JuanHauara/FPGA_development_board/doc/fotos/IMG_20260930_131612.jpg

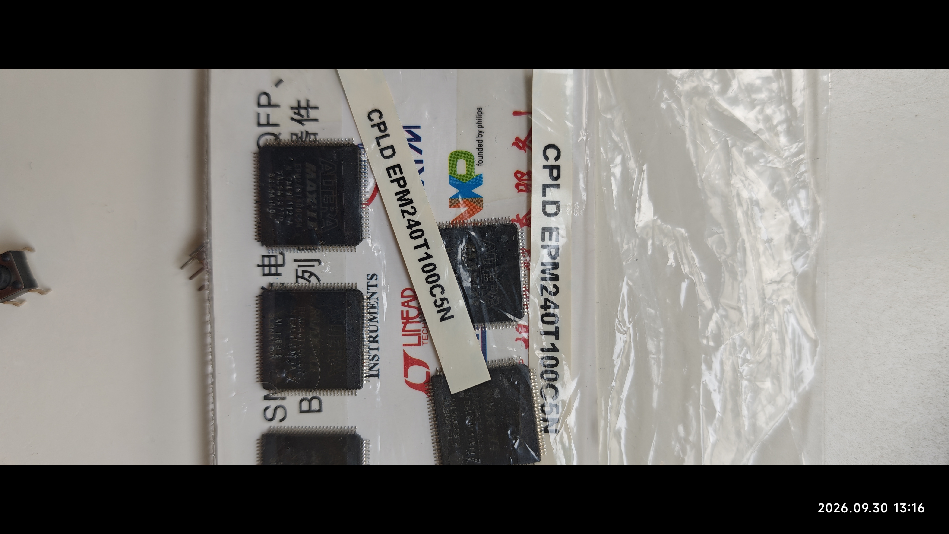
doc/fotos/IMG_20260930_131612.jpg
