JuanHauara/FPGA_development_board/doc/Datasheet/Conector hembra DC-005 alimentación CC.png

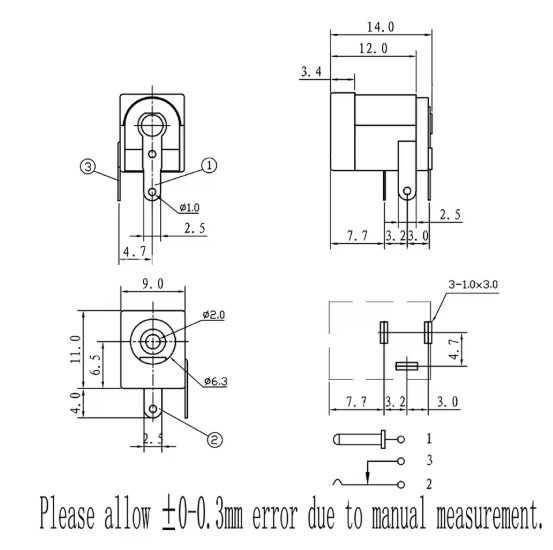
doc/Datasheet/Conector hembra DC-005 alimentación CC.png
