JuanHauara/FPGA_development_board/doc/Datasheet/seven-segment-display-diagram.jpg

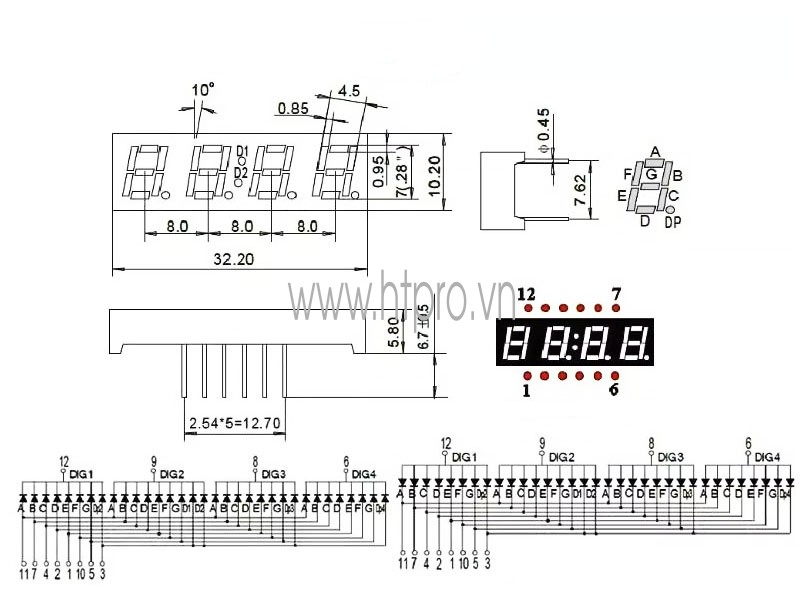
doc/Datasheet/seven-segment-display-diagram.jpg
