JuanHauara/FPGA_development_board/doc/fotos/IMG_20260930_124302.jpg

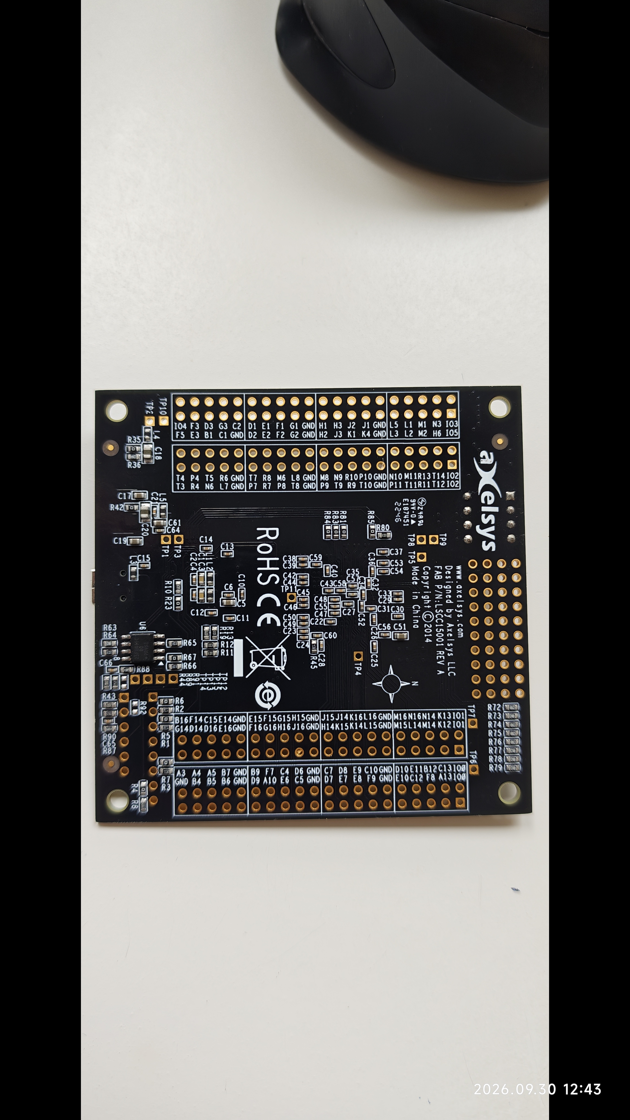
doc/fotos/IMG_20260930_124302.jpg
