JuanHauara/FPGA_development_board/doc/fotos/IMG_20260930_124416.jpg

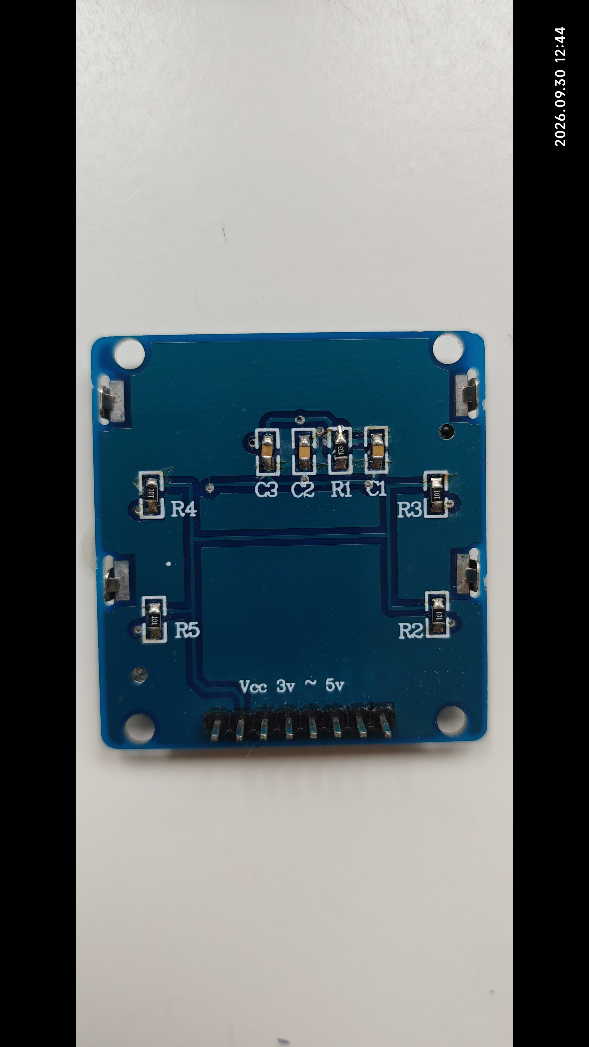
doc/fotos/IMG_20260930_124416.jpg
