JuanHauara/FPGA_development_board/doc/fotos/IMG_20260930_124644.jpg

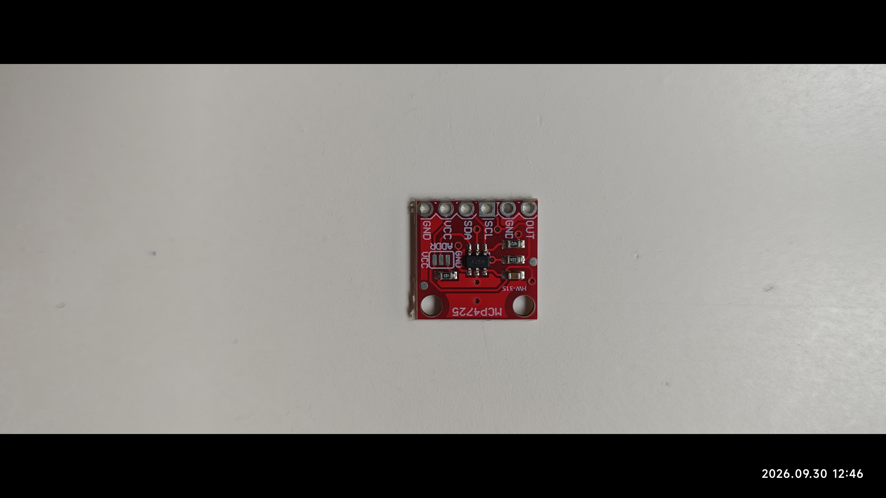
doc/fotos/IMG_20260930_124644.jpg
