JuanHauara/FPGA_development_board/doc/fotos/IMG_20260930_125004.jpg

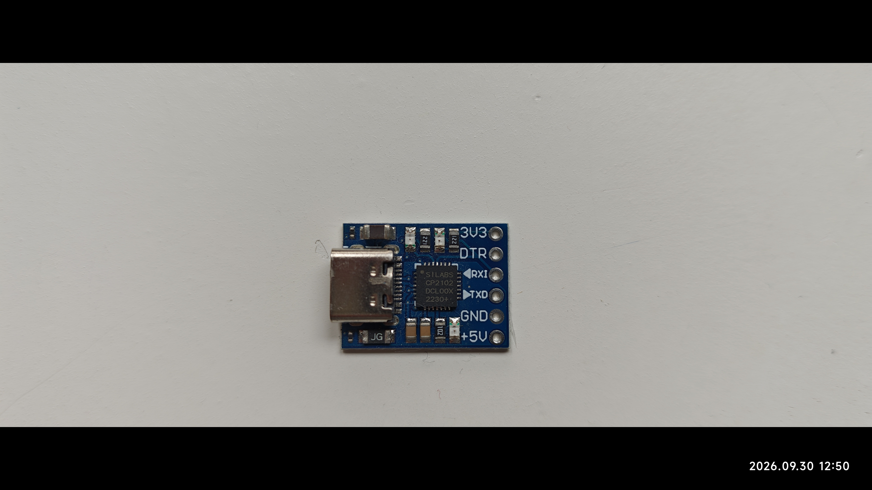
doc/fotos/IMG_20260930_125004.jpg
