JuanHauara/FPGA_development_board/doc/fotos/IMG_20260930_130410.jpg

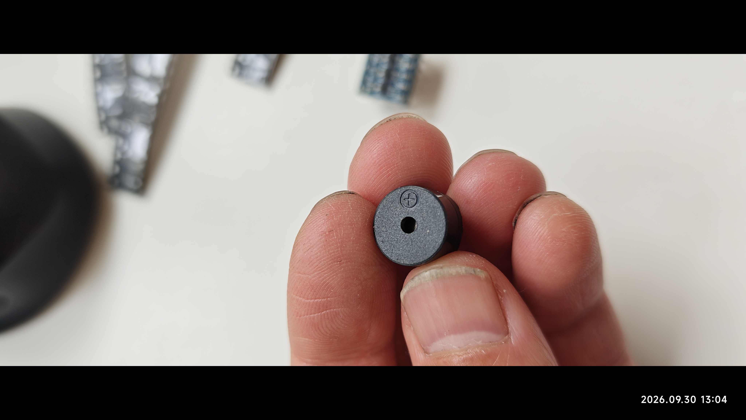
doc/fotos/IMG_20260930_130410.jpg
