JuanHauara/FPGA_development_board/doc/fotos/IMG_20260930_130453.jpg

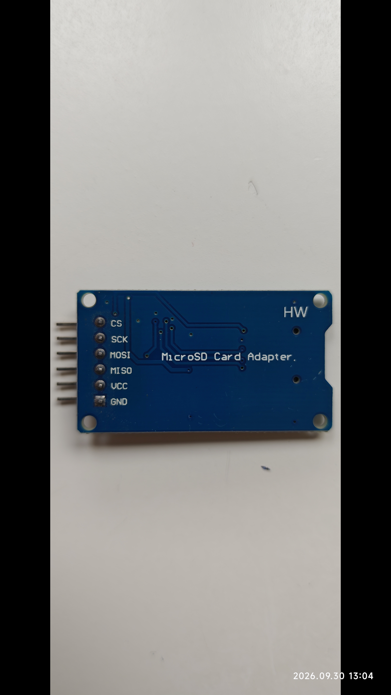
doc/fotos/IMG_20260930_130453.jpg
