JuanHauara/FPGA_development_board/doc/fotos/IMG_20260930_130505.jpg

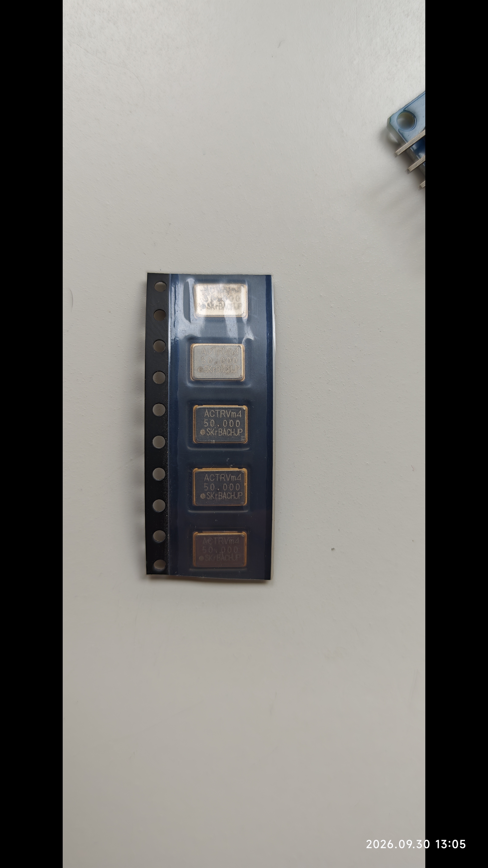
doc/fotos/IMG_20260930_130505.jpg
