JuanHauara/FPGA_development_board/doc/fotos/IMG_20260930_131454.jpg

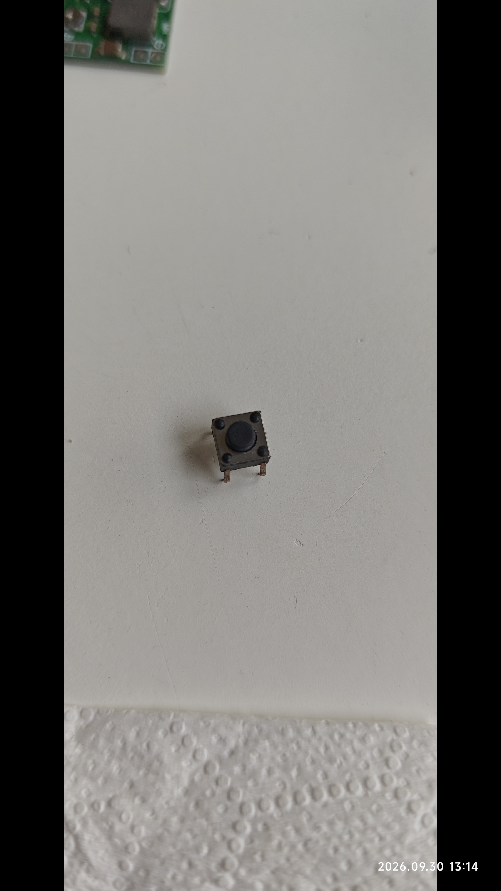
doc/fotos/IMG_20260930_131454.jpg
