JuanHauara/FPGA_development_board/doc/fotos/IMG_20260930_132716.jpg

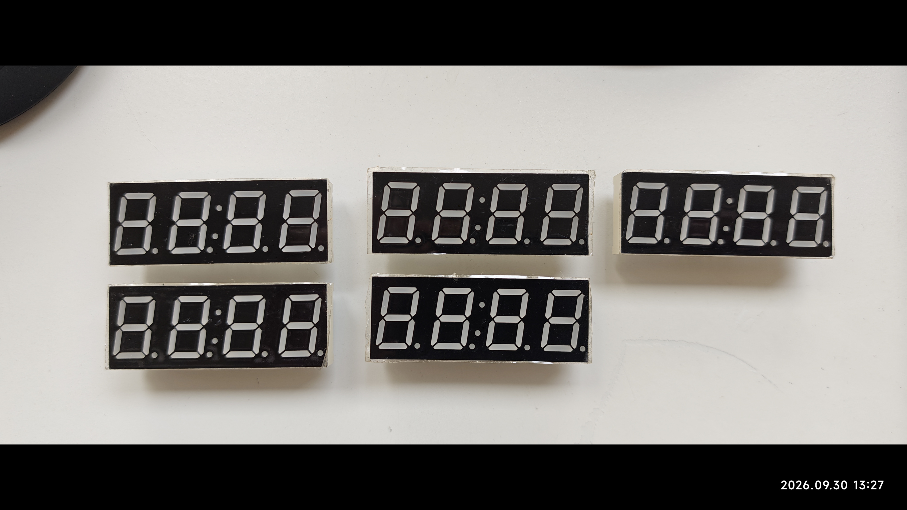
doc/fotos/IMG_20260930_132716.jpg
