JuanHauara/FPGA_development_board/doc/fotos/IMG_20260930_132906.jpg

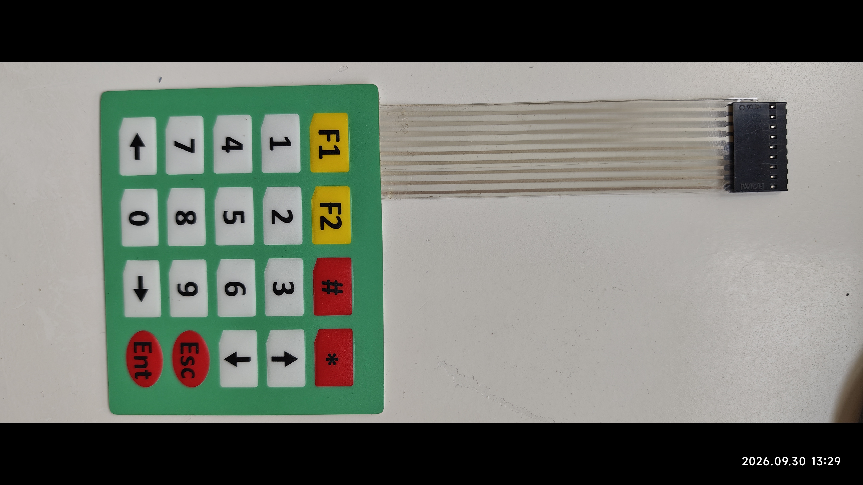
doc/fotos/IMG_20260930_132906.jpg
