JuanHauara/FPGA_development_board/doc/imgs/TSOP II 32 - SRAM.jpg

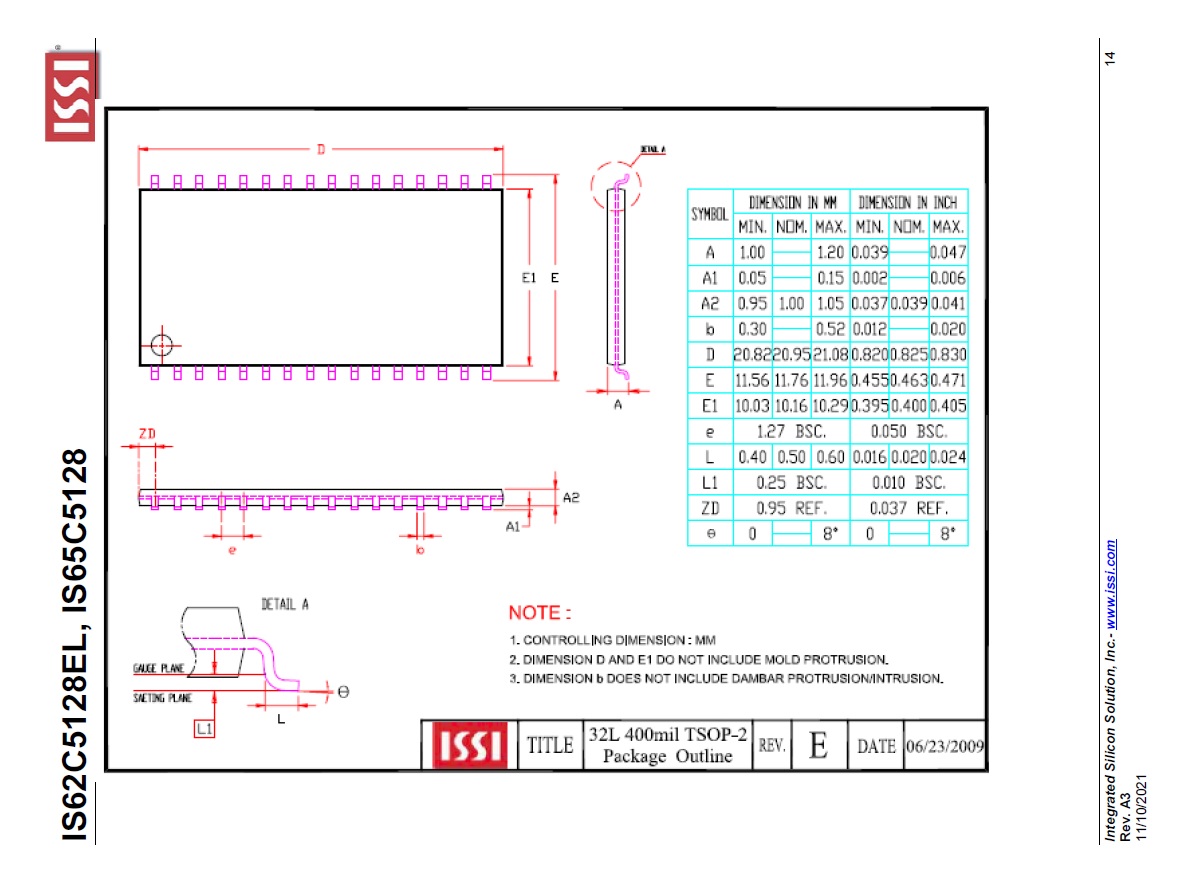
doc/imgs/TSOP II 32 - SRAM.jpg
