JuanHauara/FPGA_development_board/tmp/pdfs/nxp244local.png

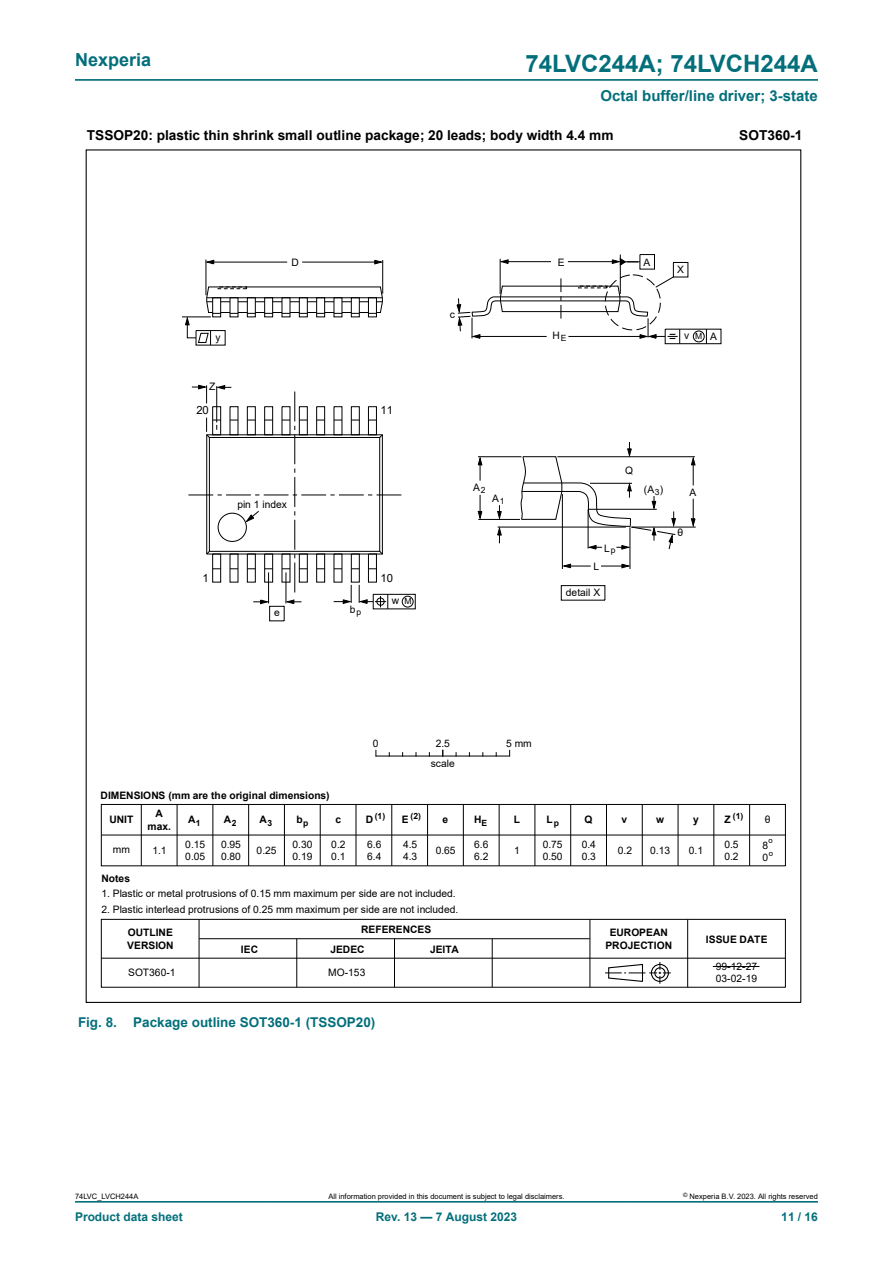
tmp/pdfs/nxp244local.png
