JuanHauara/FPGA_development_board/tmp/pdfs/ti244.png

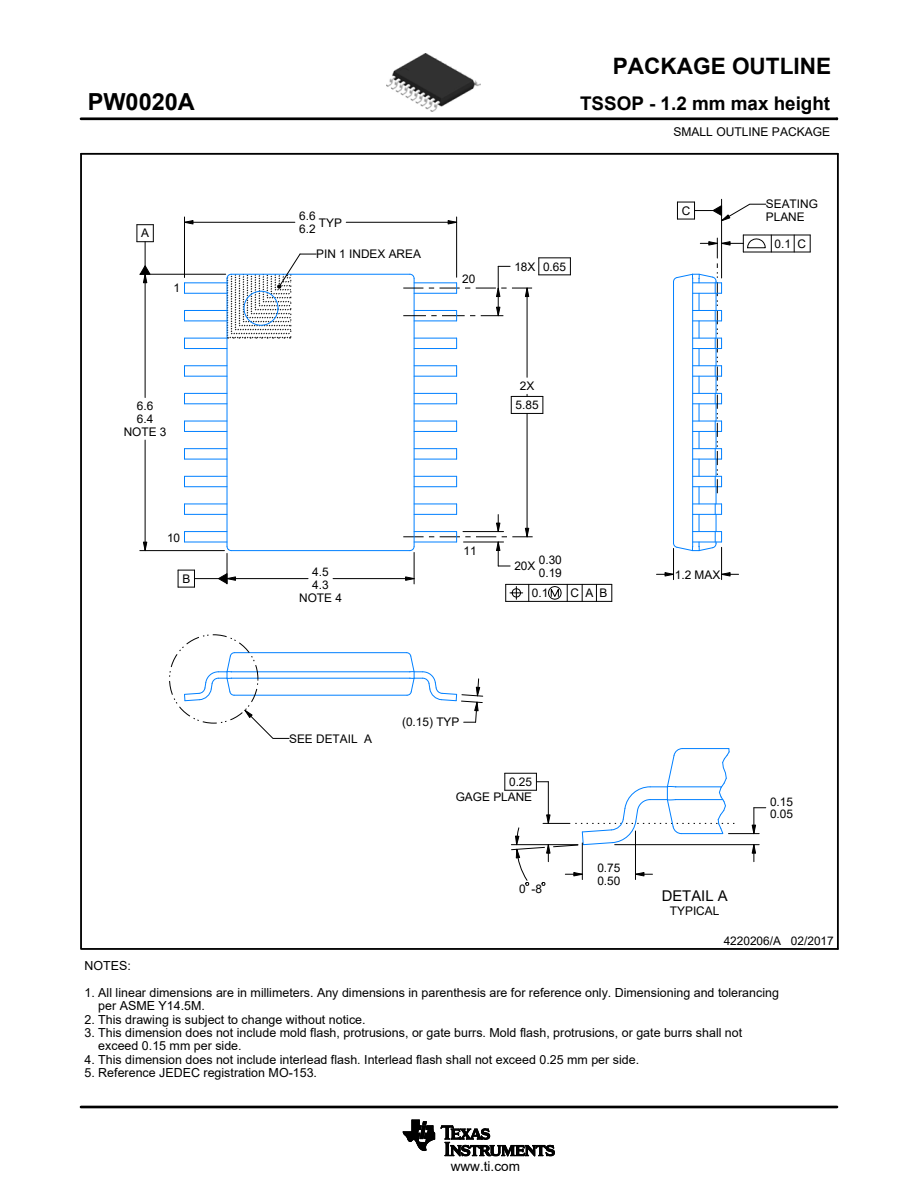
tmp/pdfs/ti244.png
