JuanHauara/FPGA_development_board/doc/Datasheet/Placa_MCUDev_DevEBox_STM32H7XX_M/PCB_measures.png

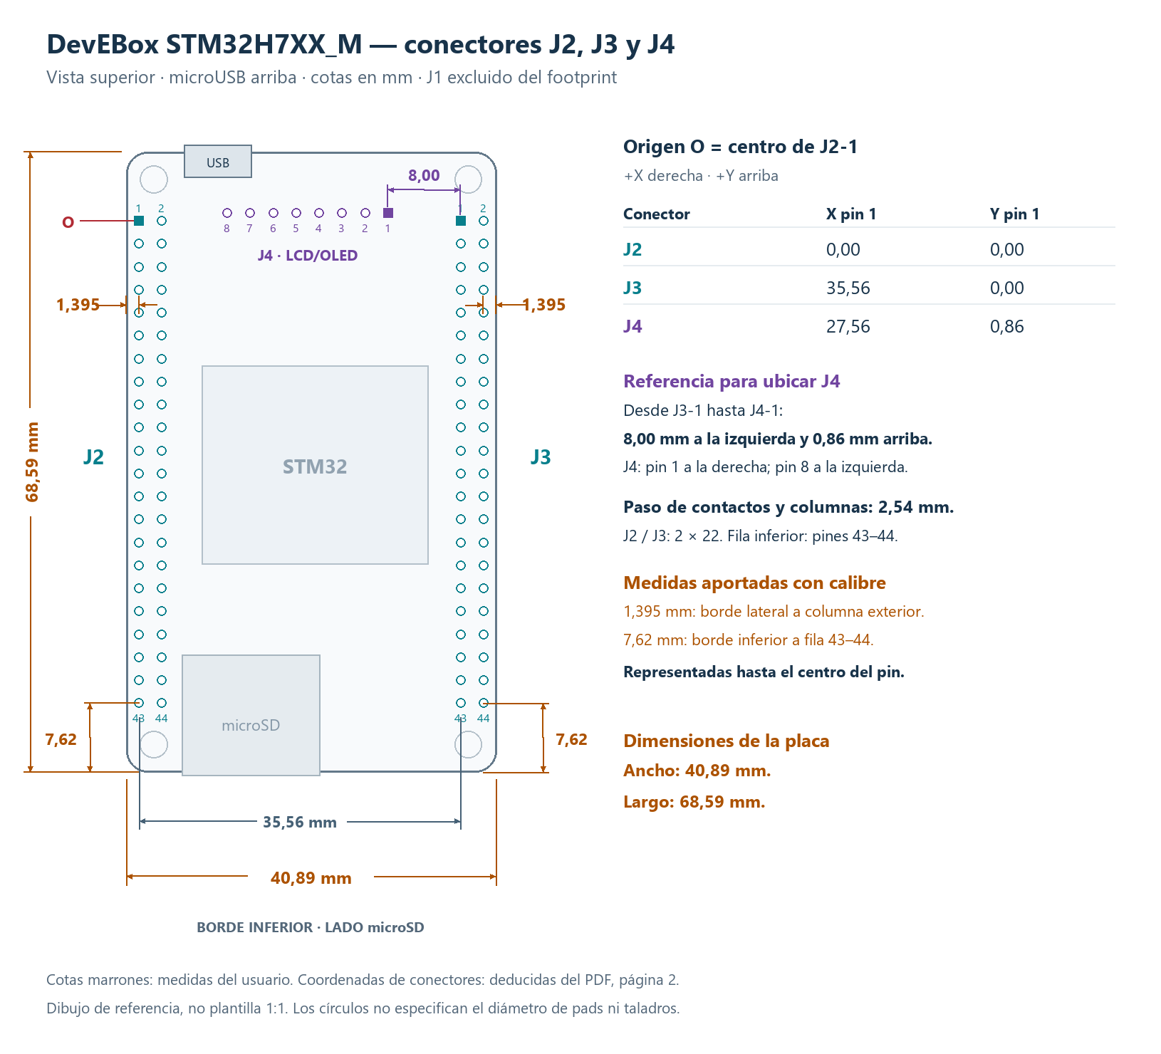
doc/Datasheet/Placa_MCUDev_DevEBox_STM32H7XX_M/PCB_measures.png
