JuanHauara/FPGA_development_board/doc/Export/Lattice_FPGA_development_board.pdf

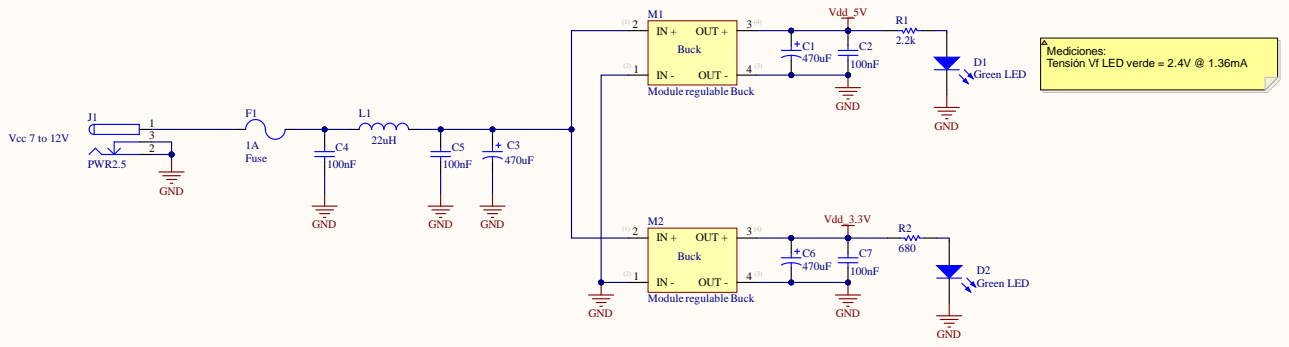
[picture p28: page 1]

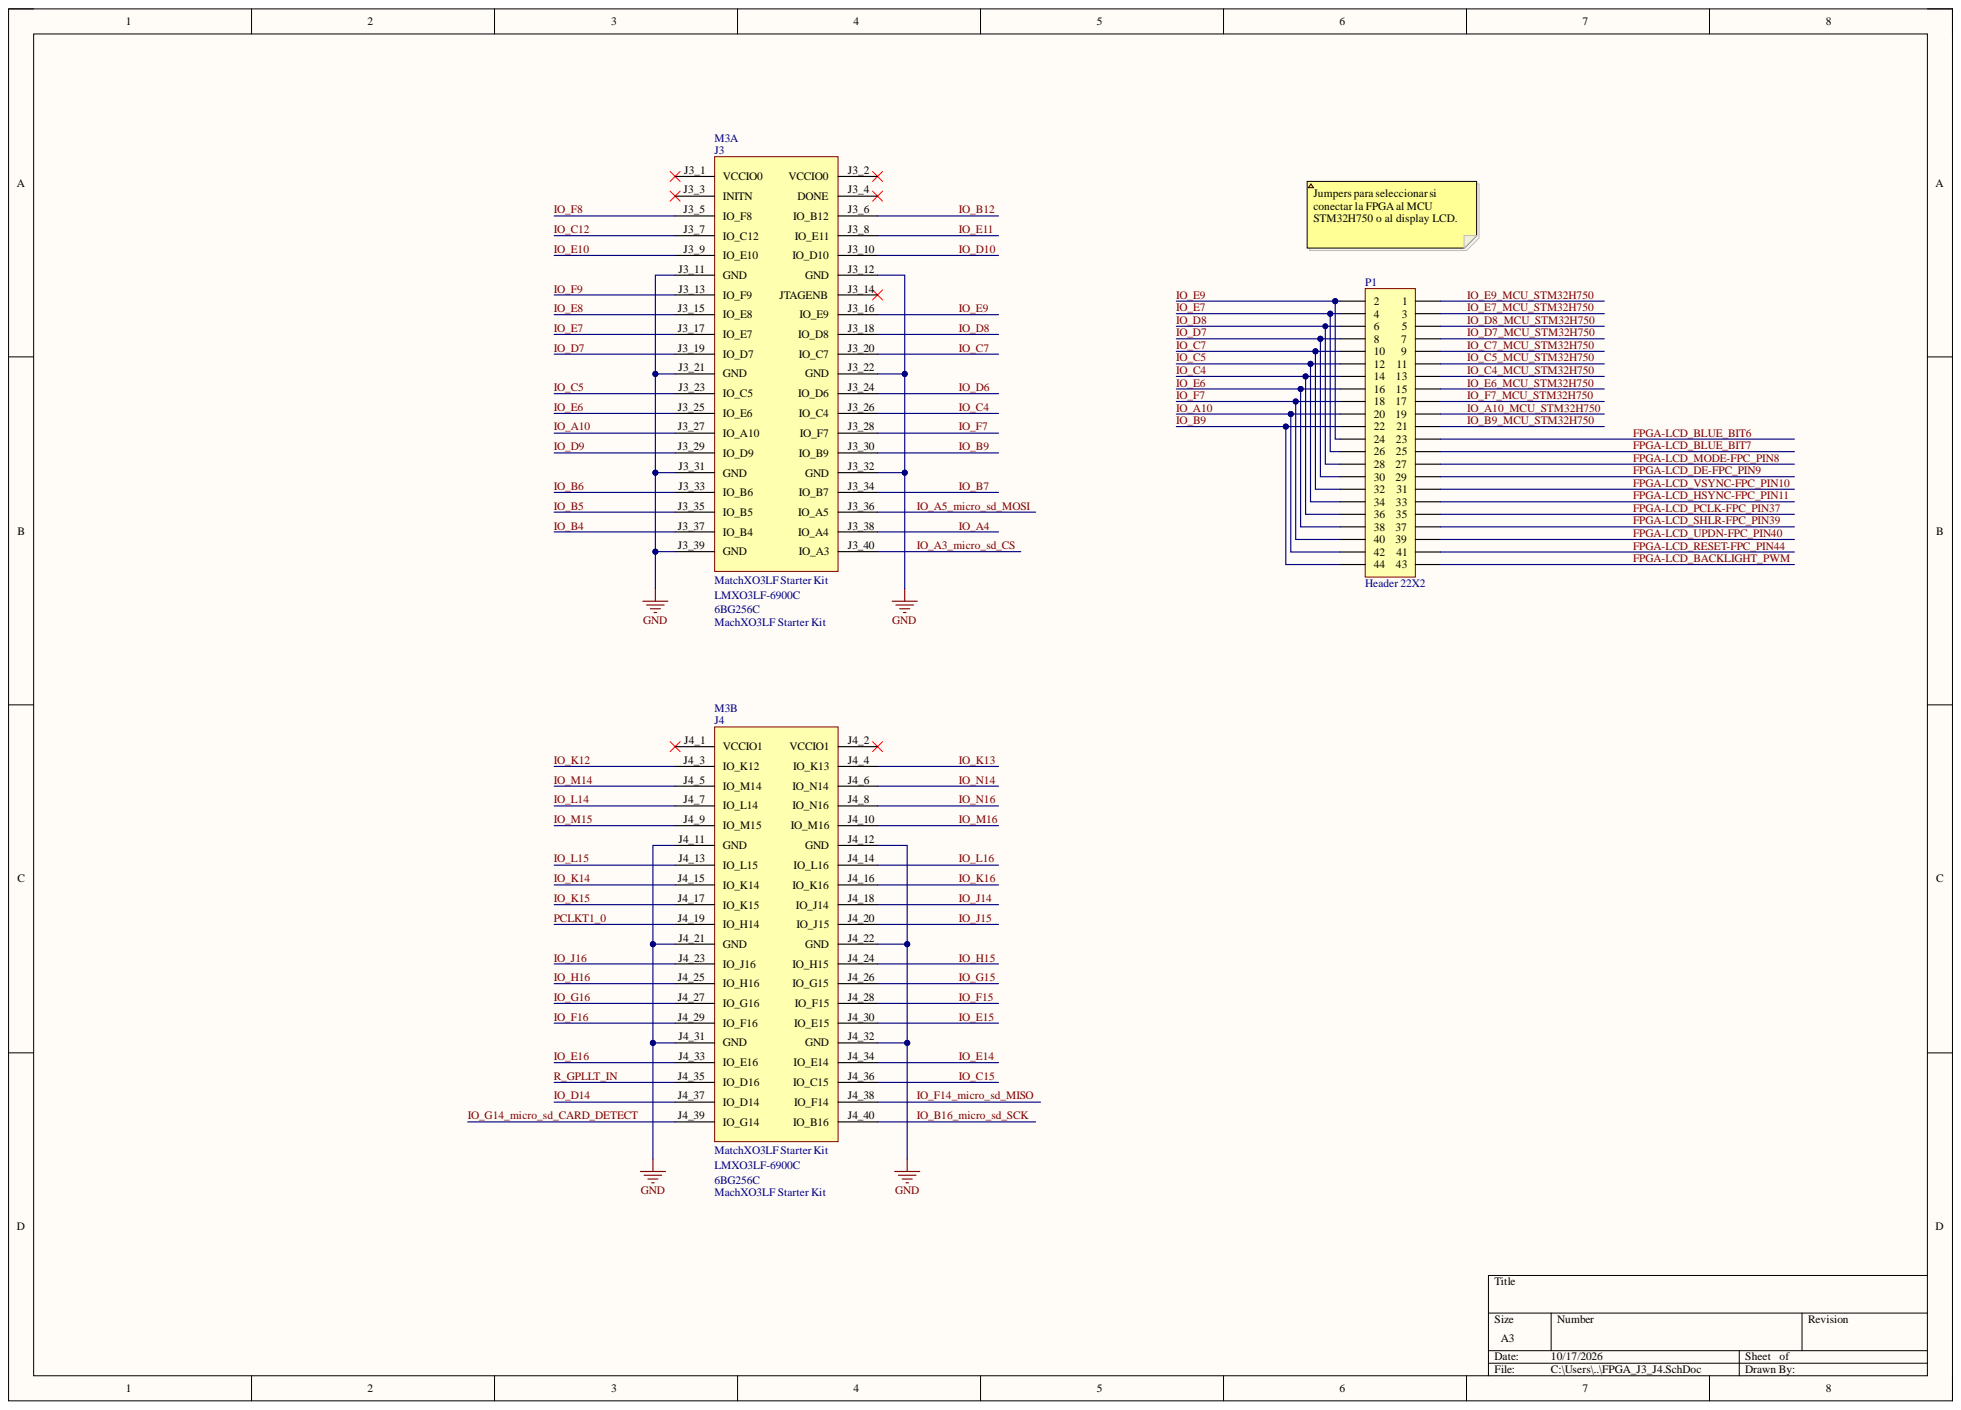
[picture p29: page 2]

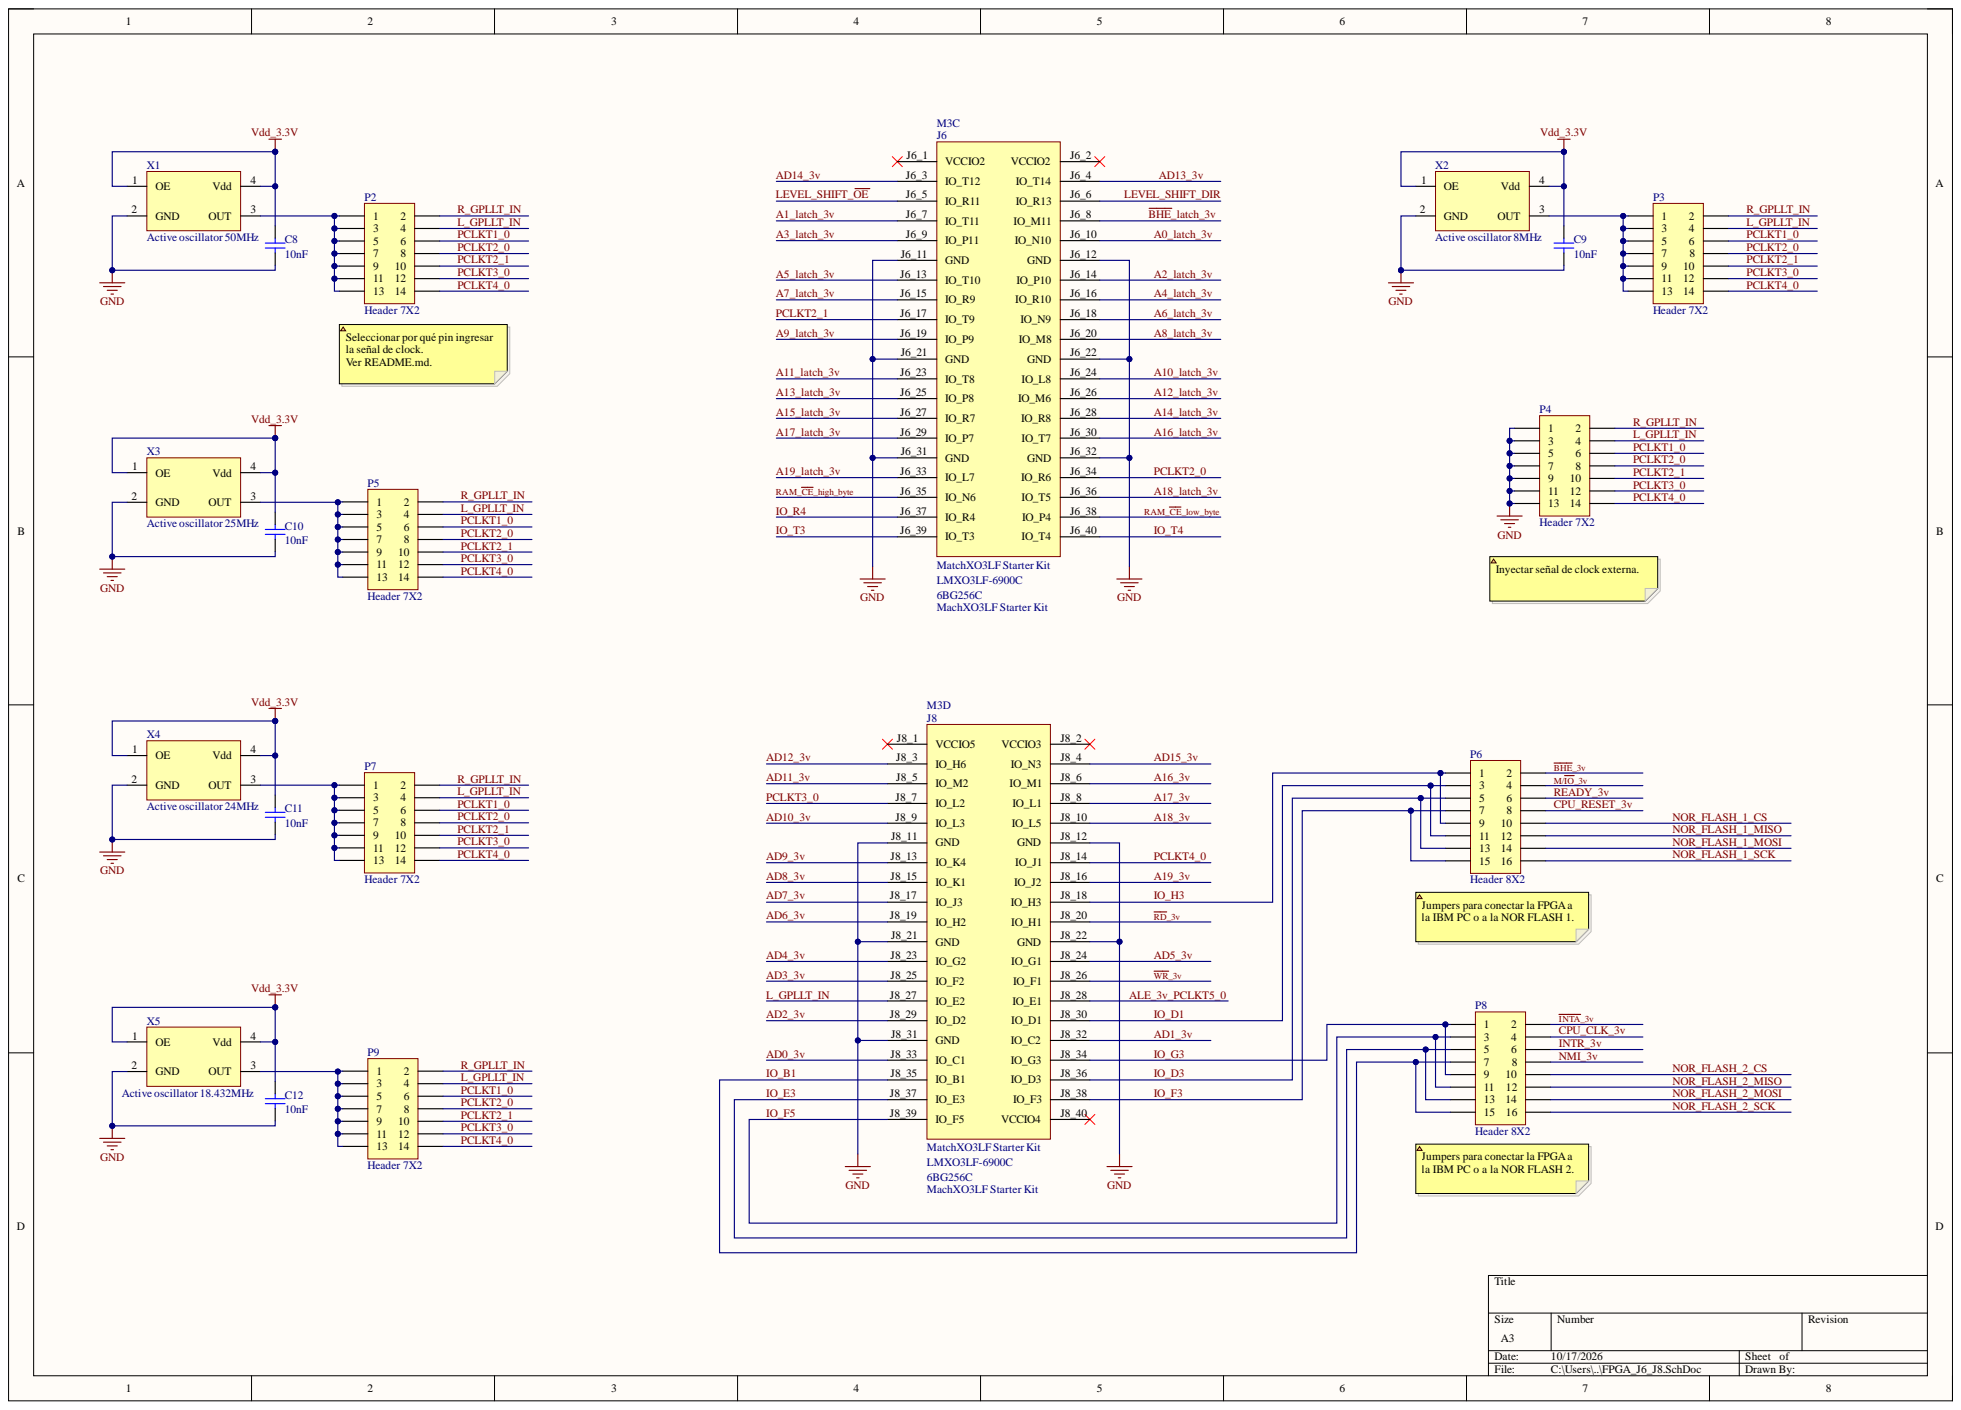
[picture p30: page 3]

ñal de clock externa.

J8_3 0 | I O_D 1
J8_3 2 J8_3 4 | | A D1_3v I O_G 3

Act Hz

I O_E 3 | J8_3 7 | J8_3 8 | I O_F3
I O_F5 | J8_3 9 | J8_4 0

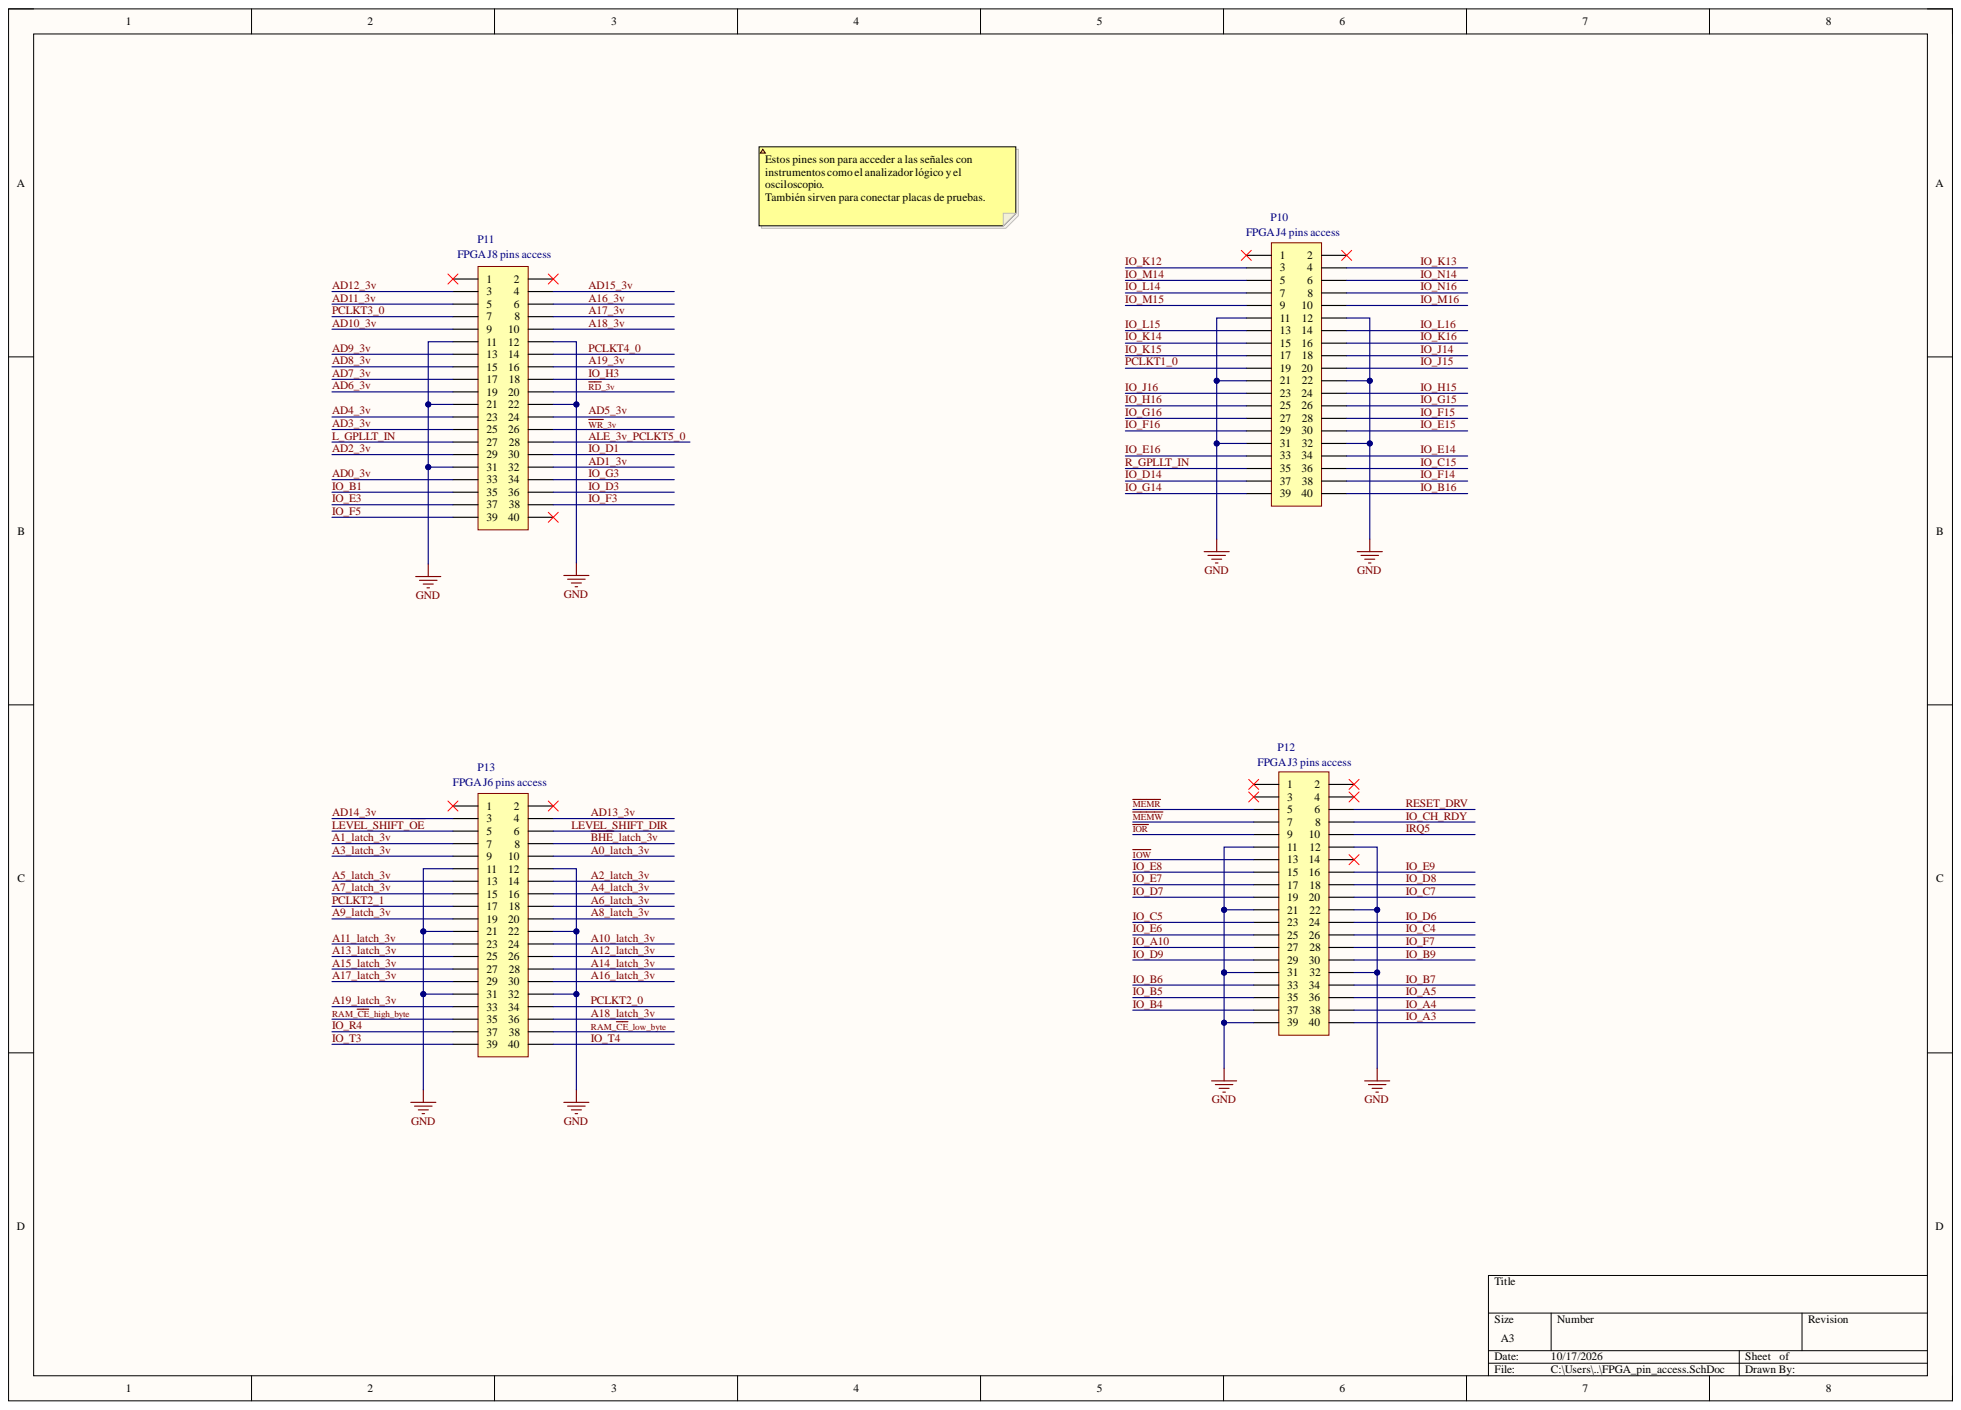
[picture p31: page 4]

rven para conectar placas de pruebas

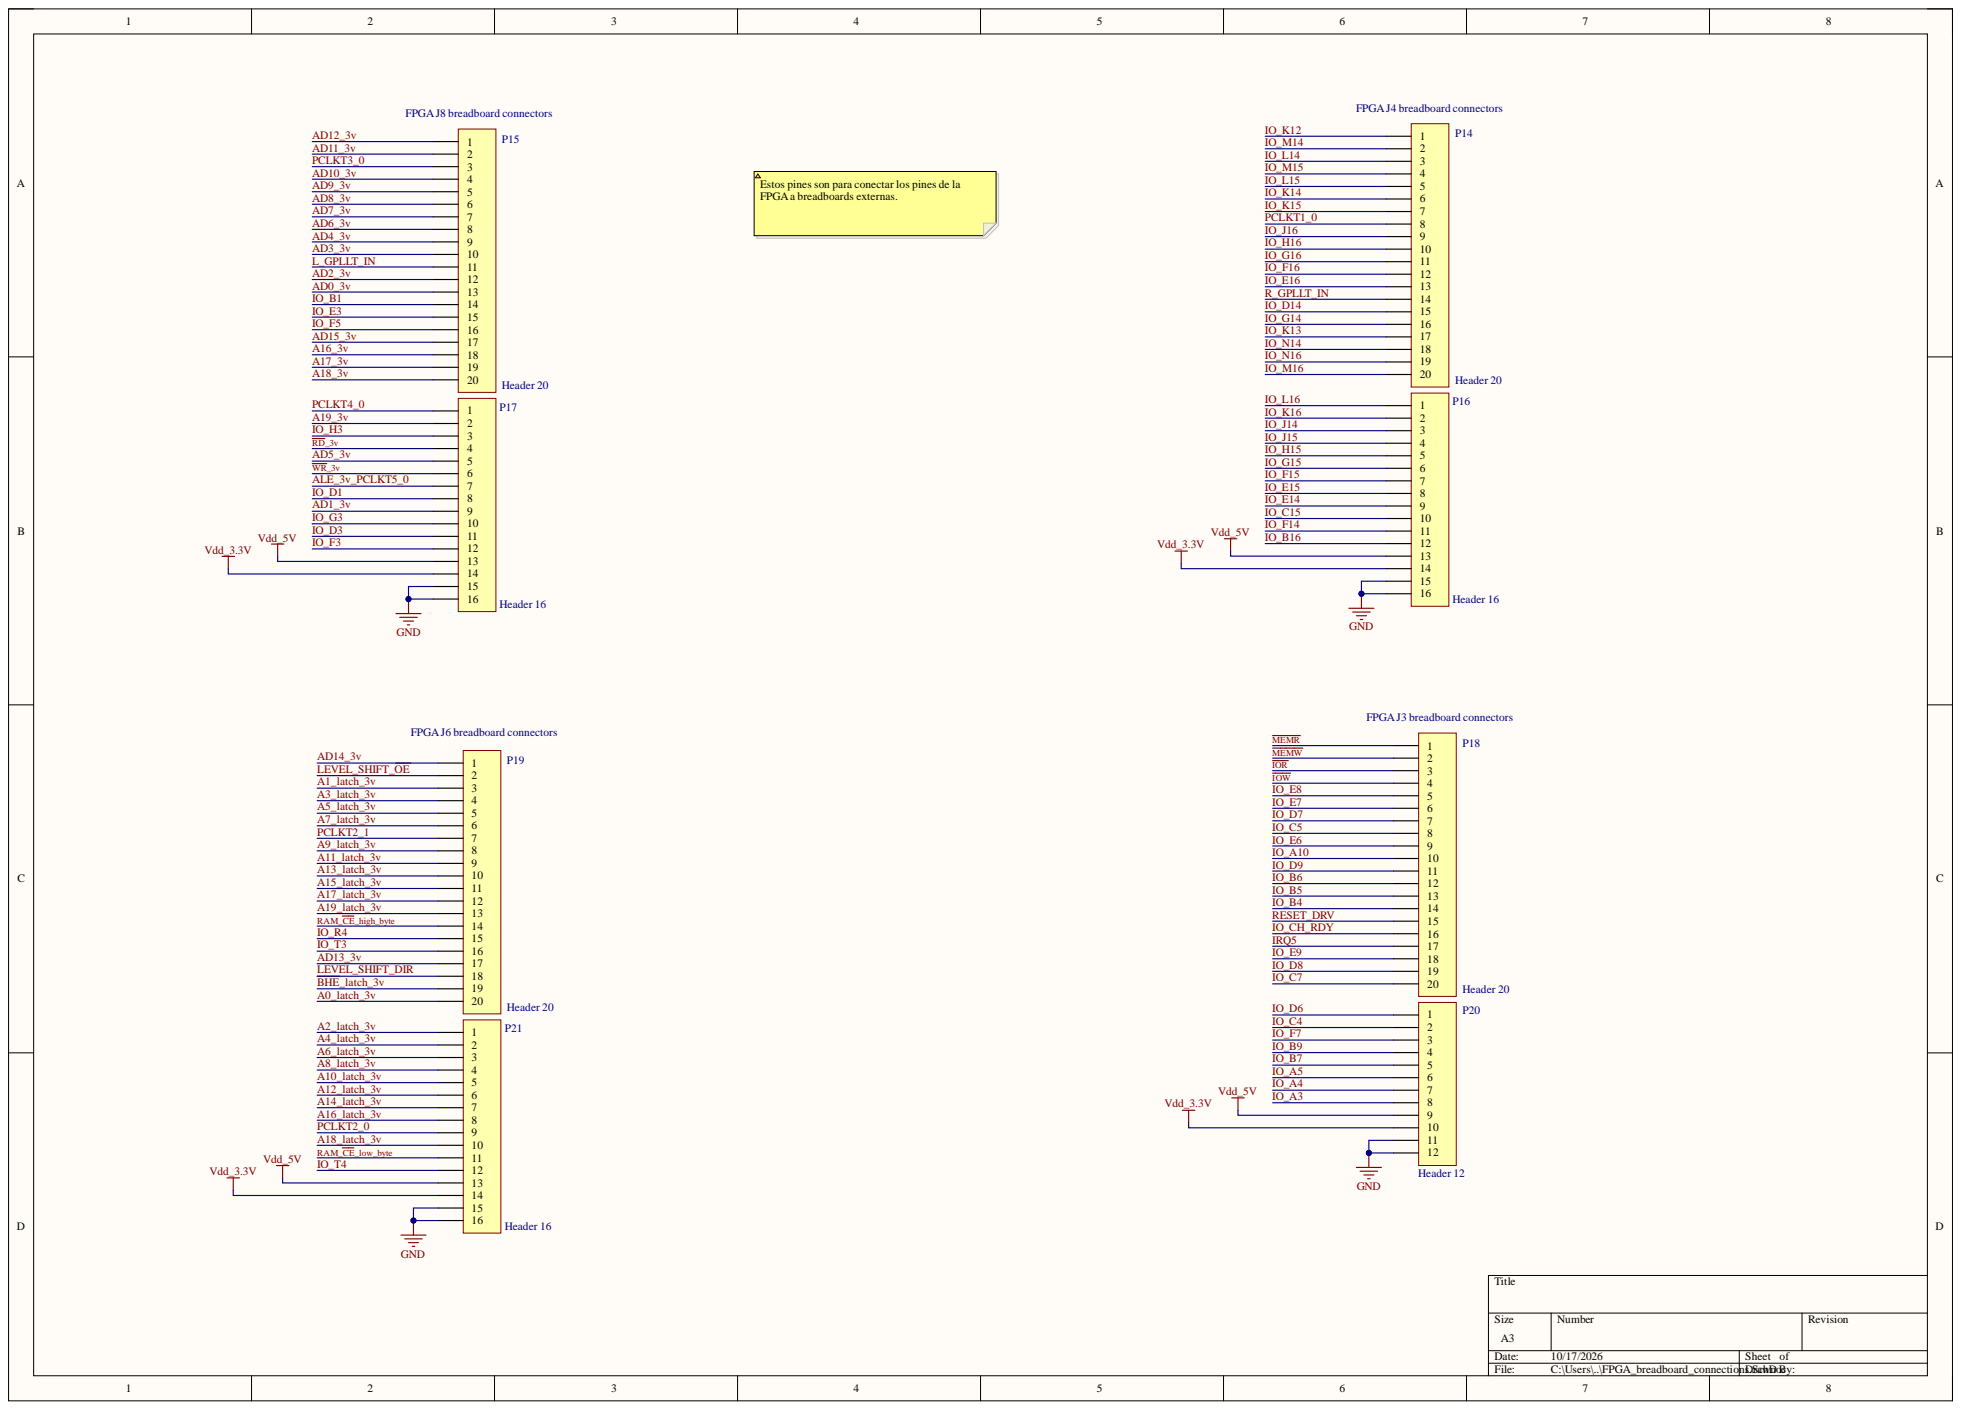
[picture p32: page 5]

ionsD.Sch rawDn Bocy:

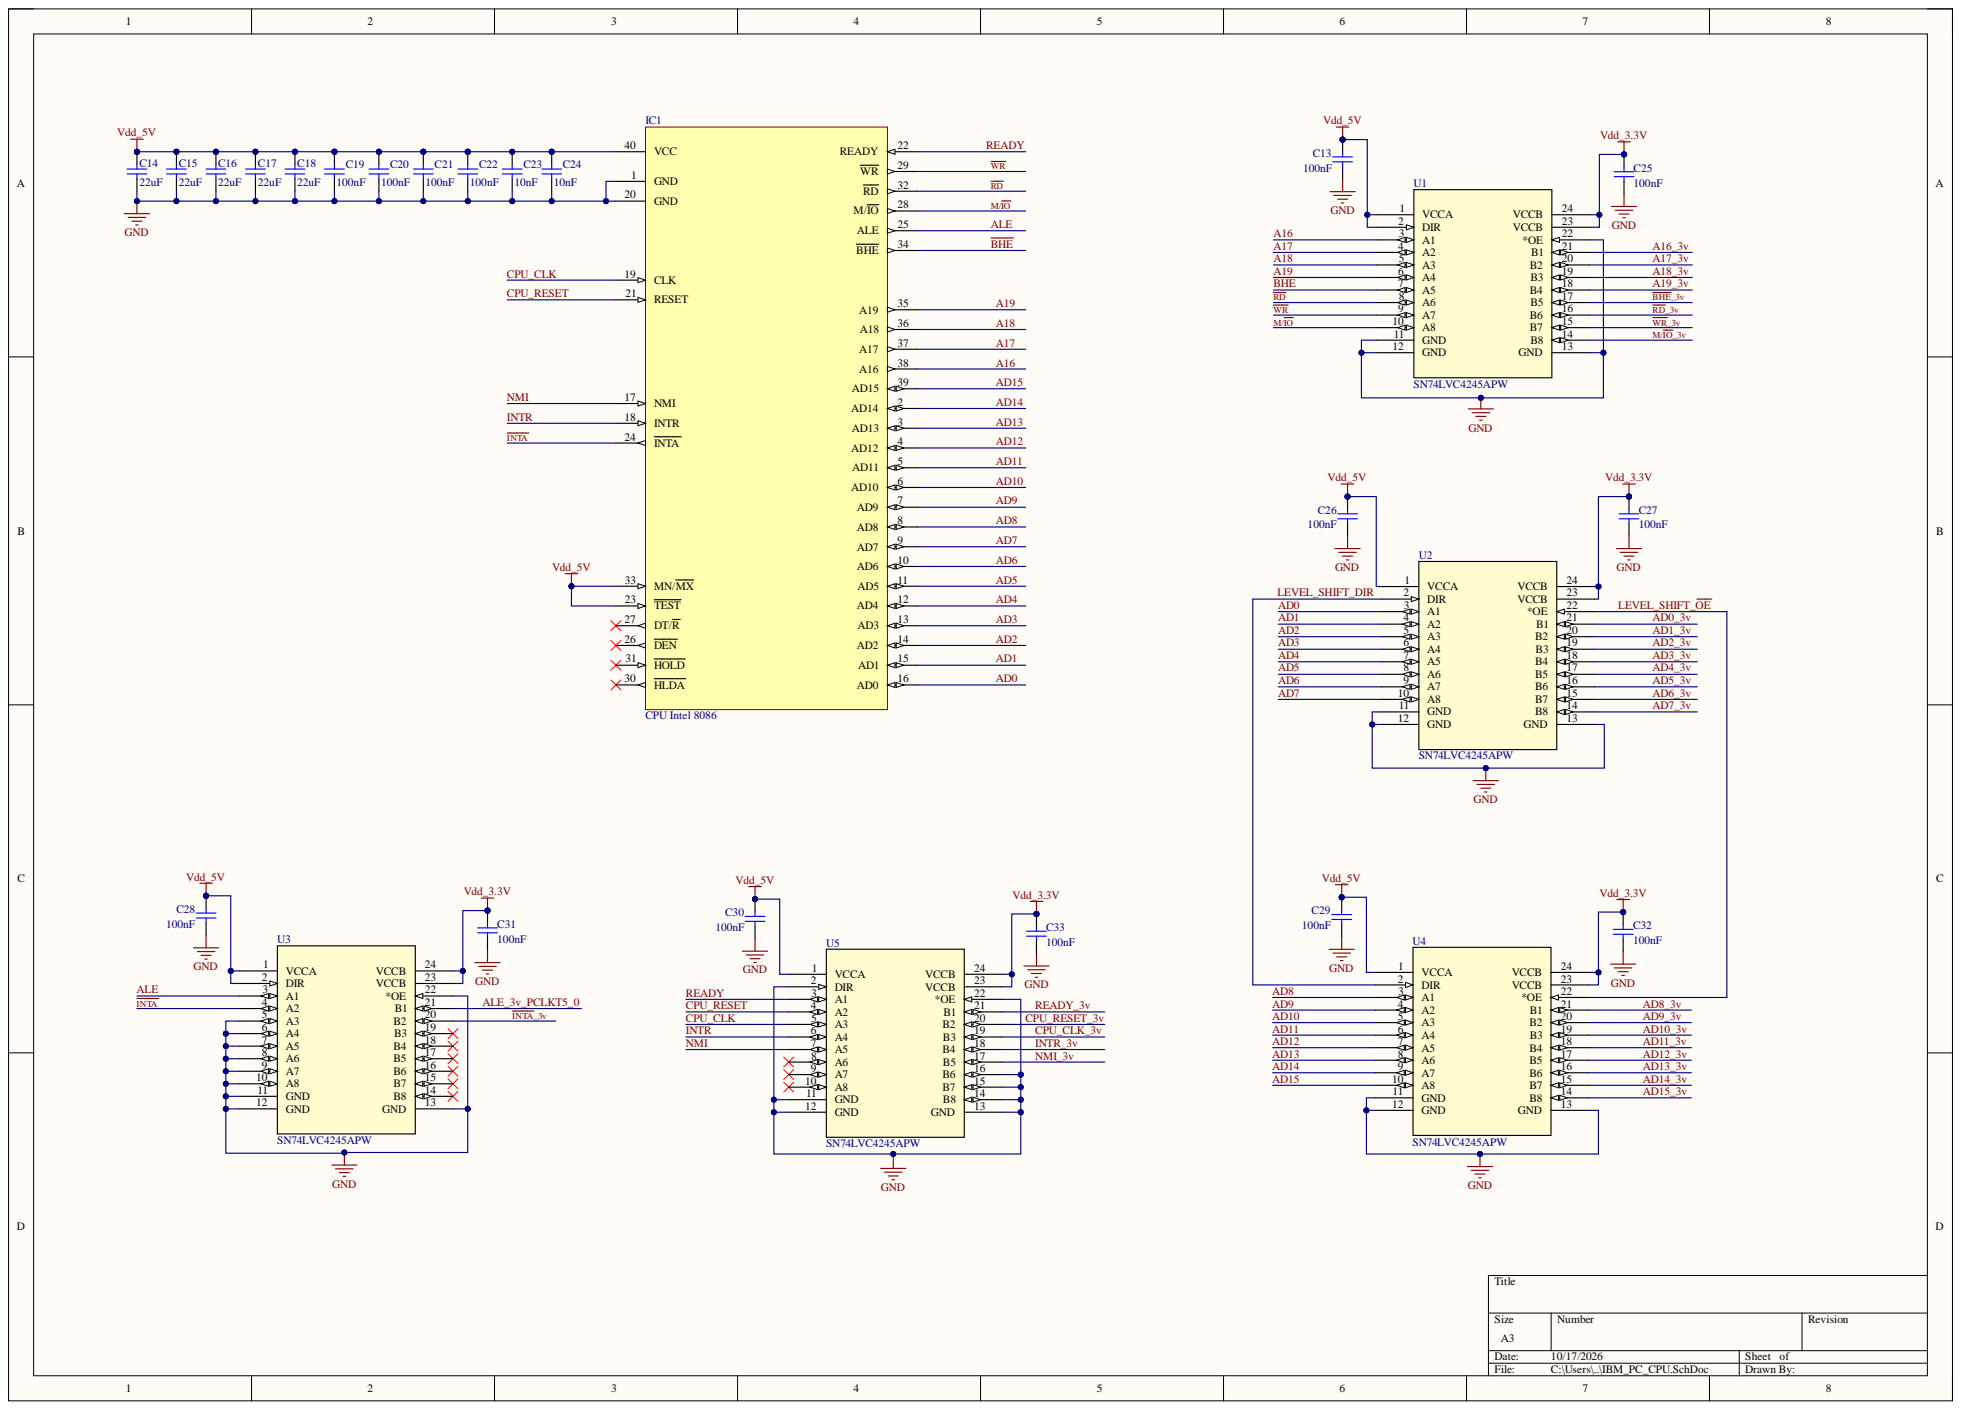
[picture p33: page 6]

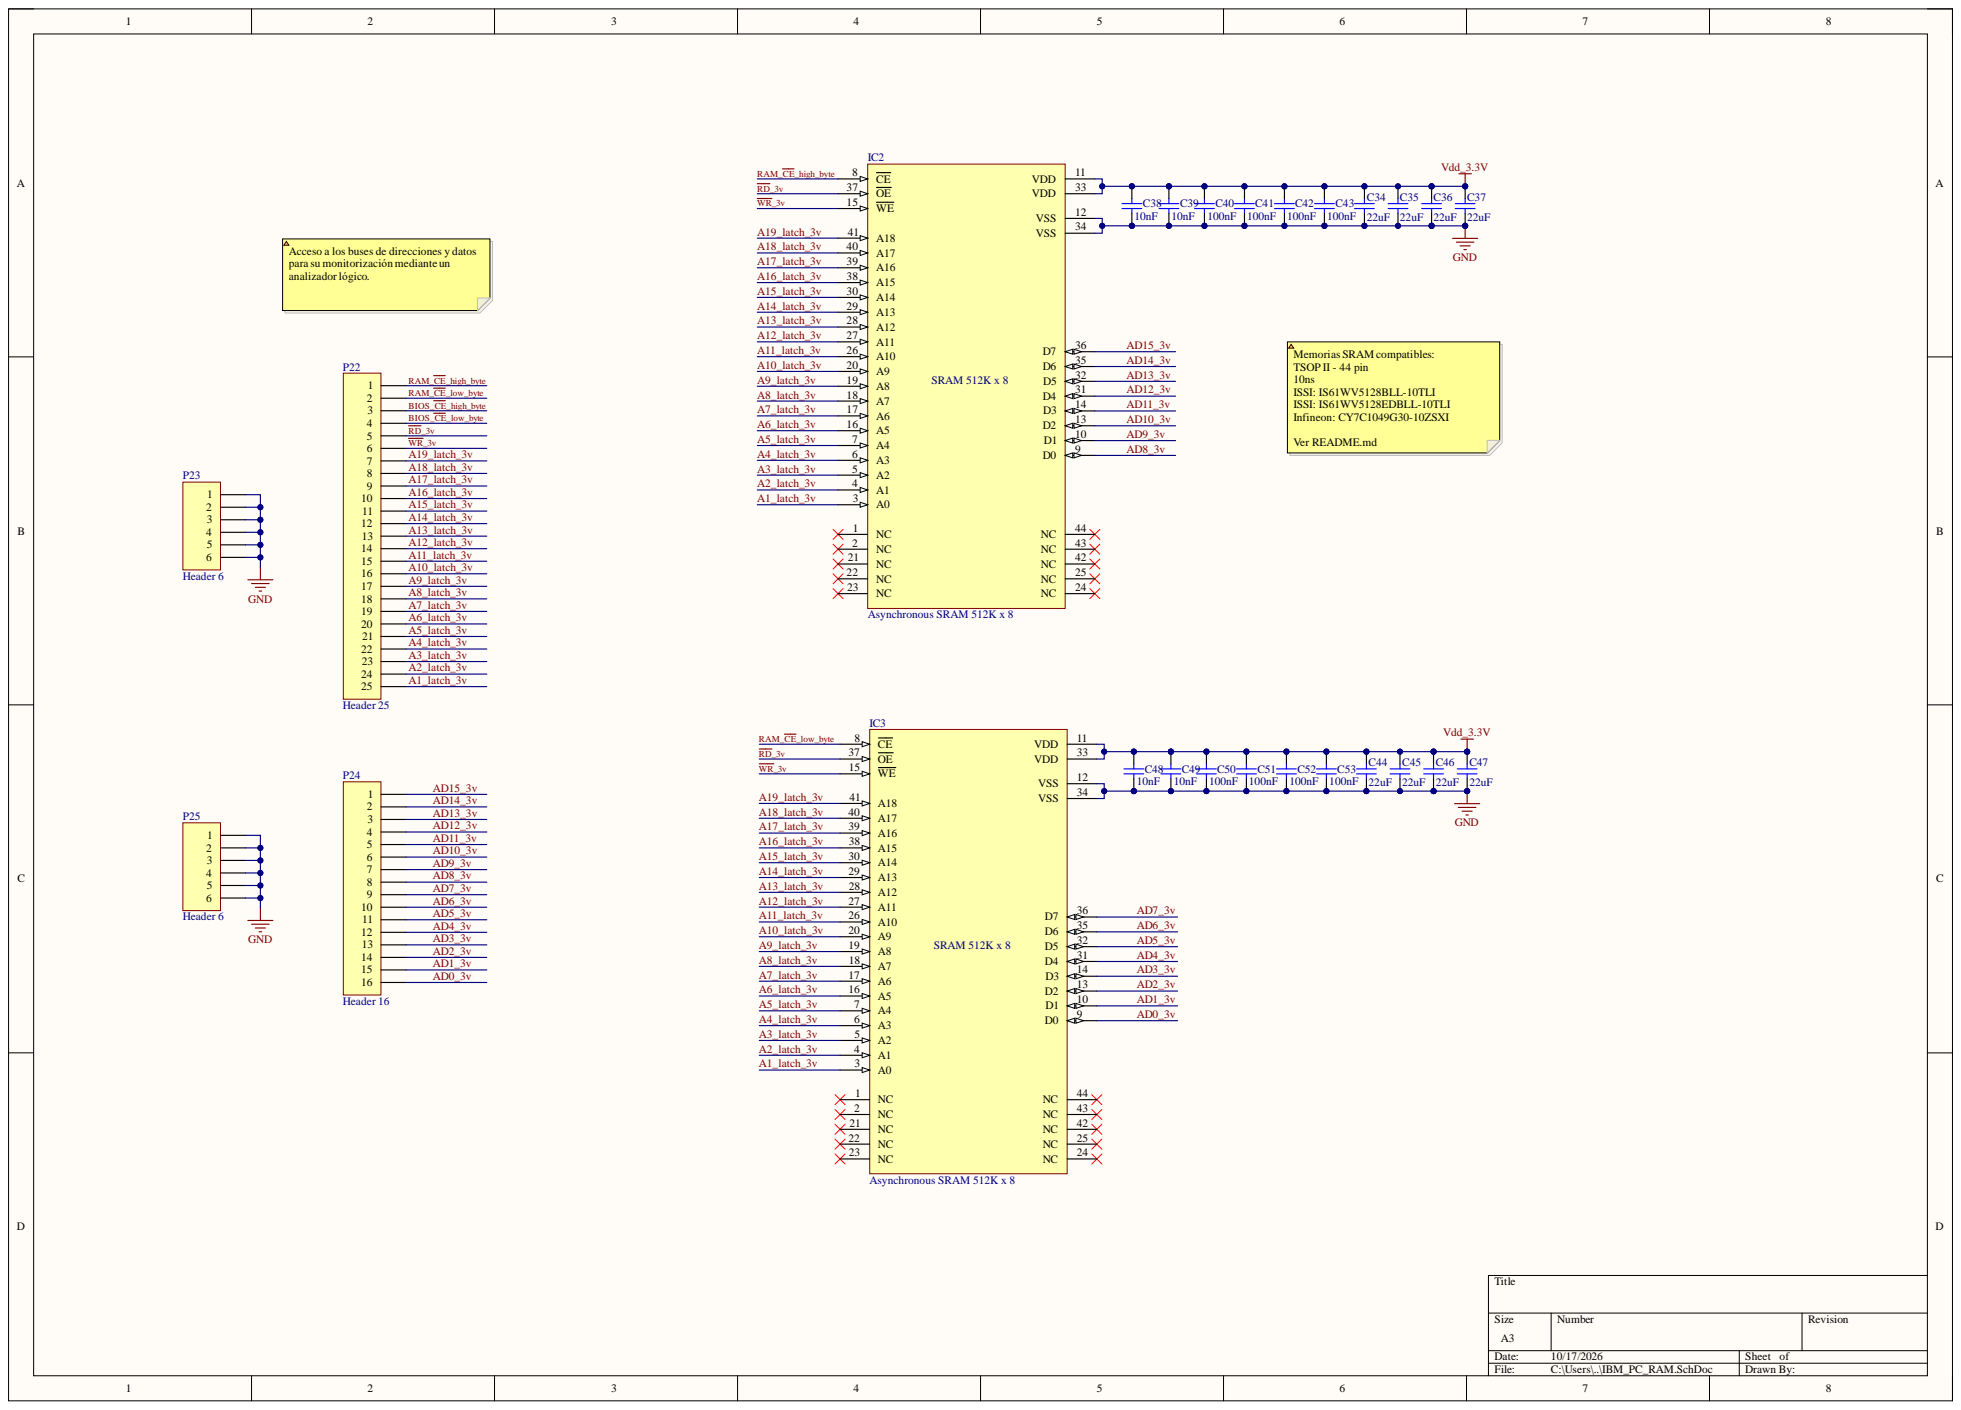
[picture p34: page 7]

los buses de di
izador

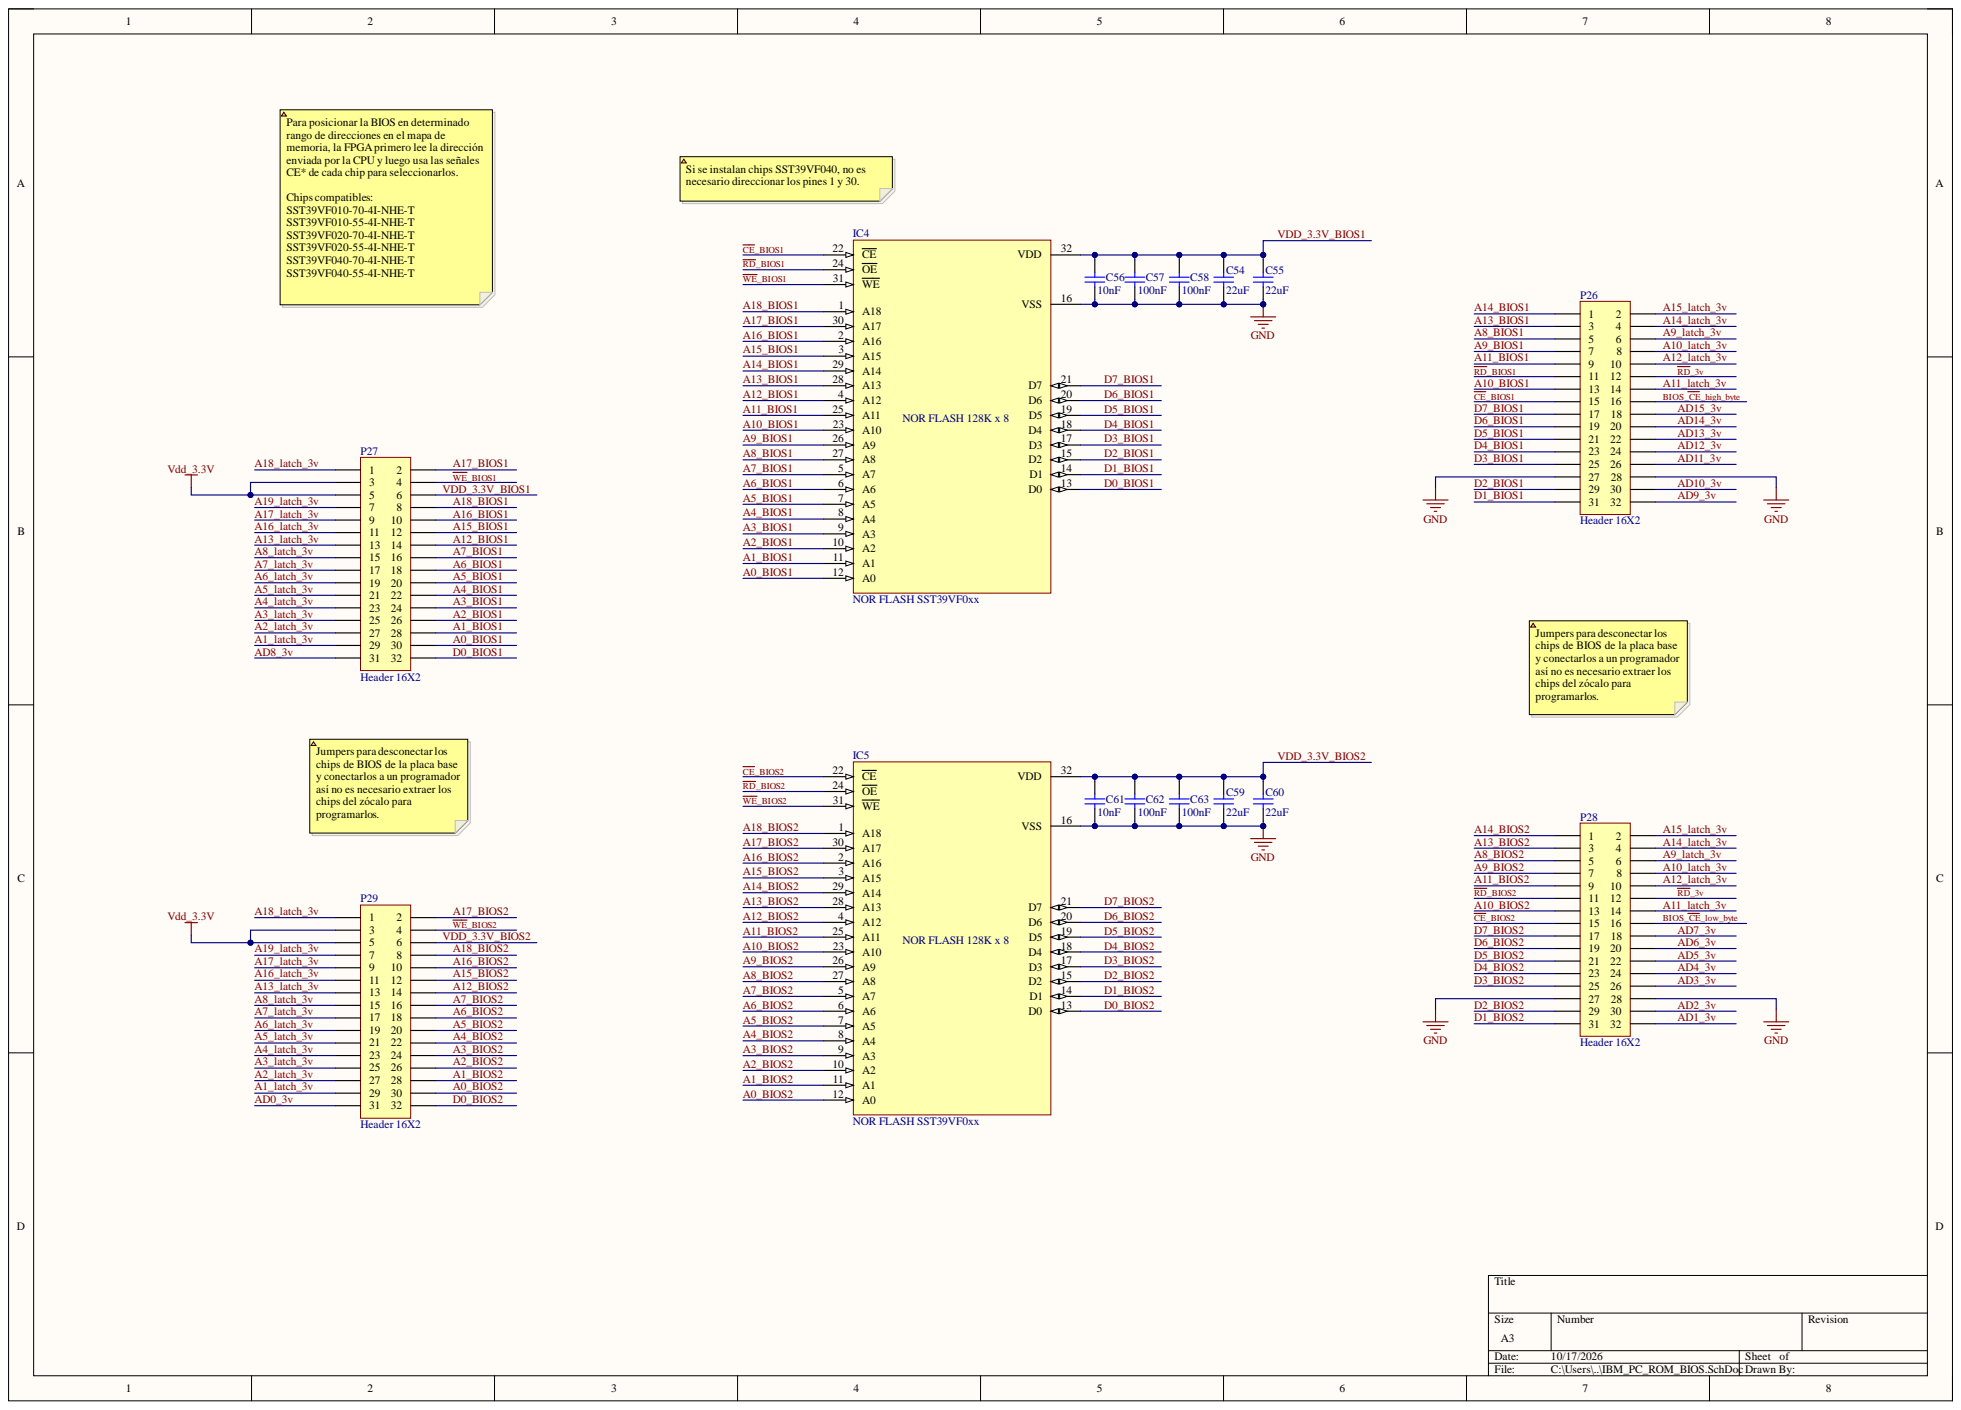
[picture p35: page 8]

E* de cada chip para

talan chips SST39VF040, no es

OS de la placa base

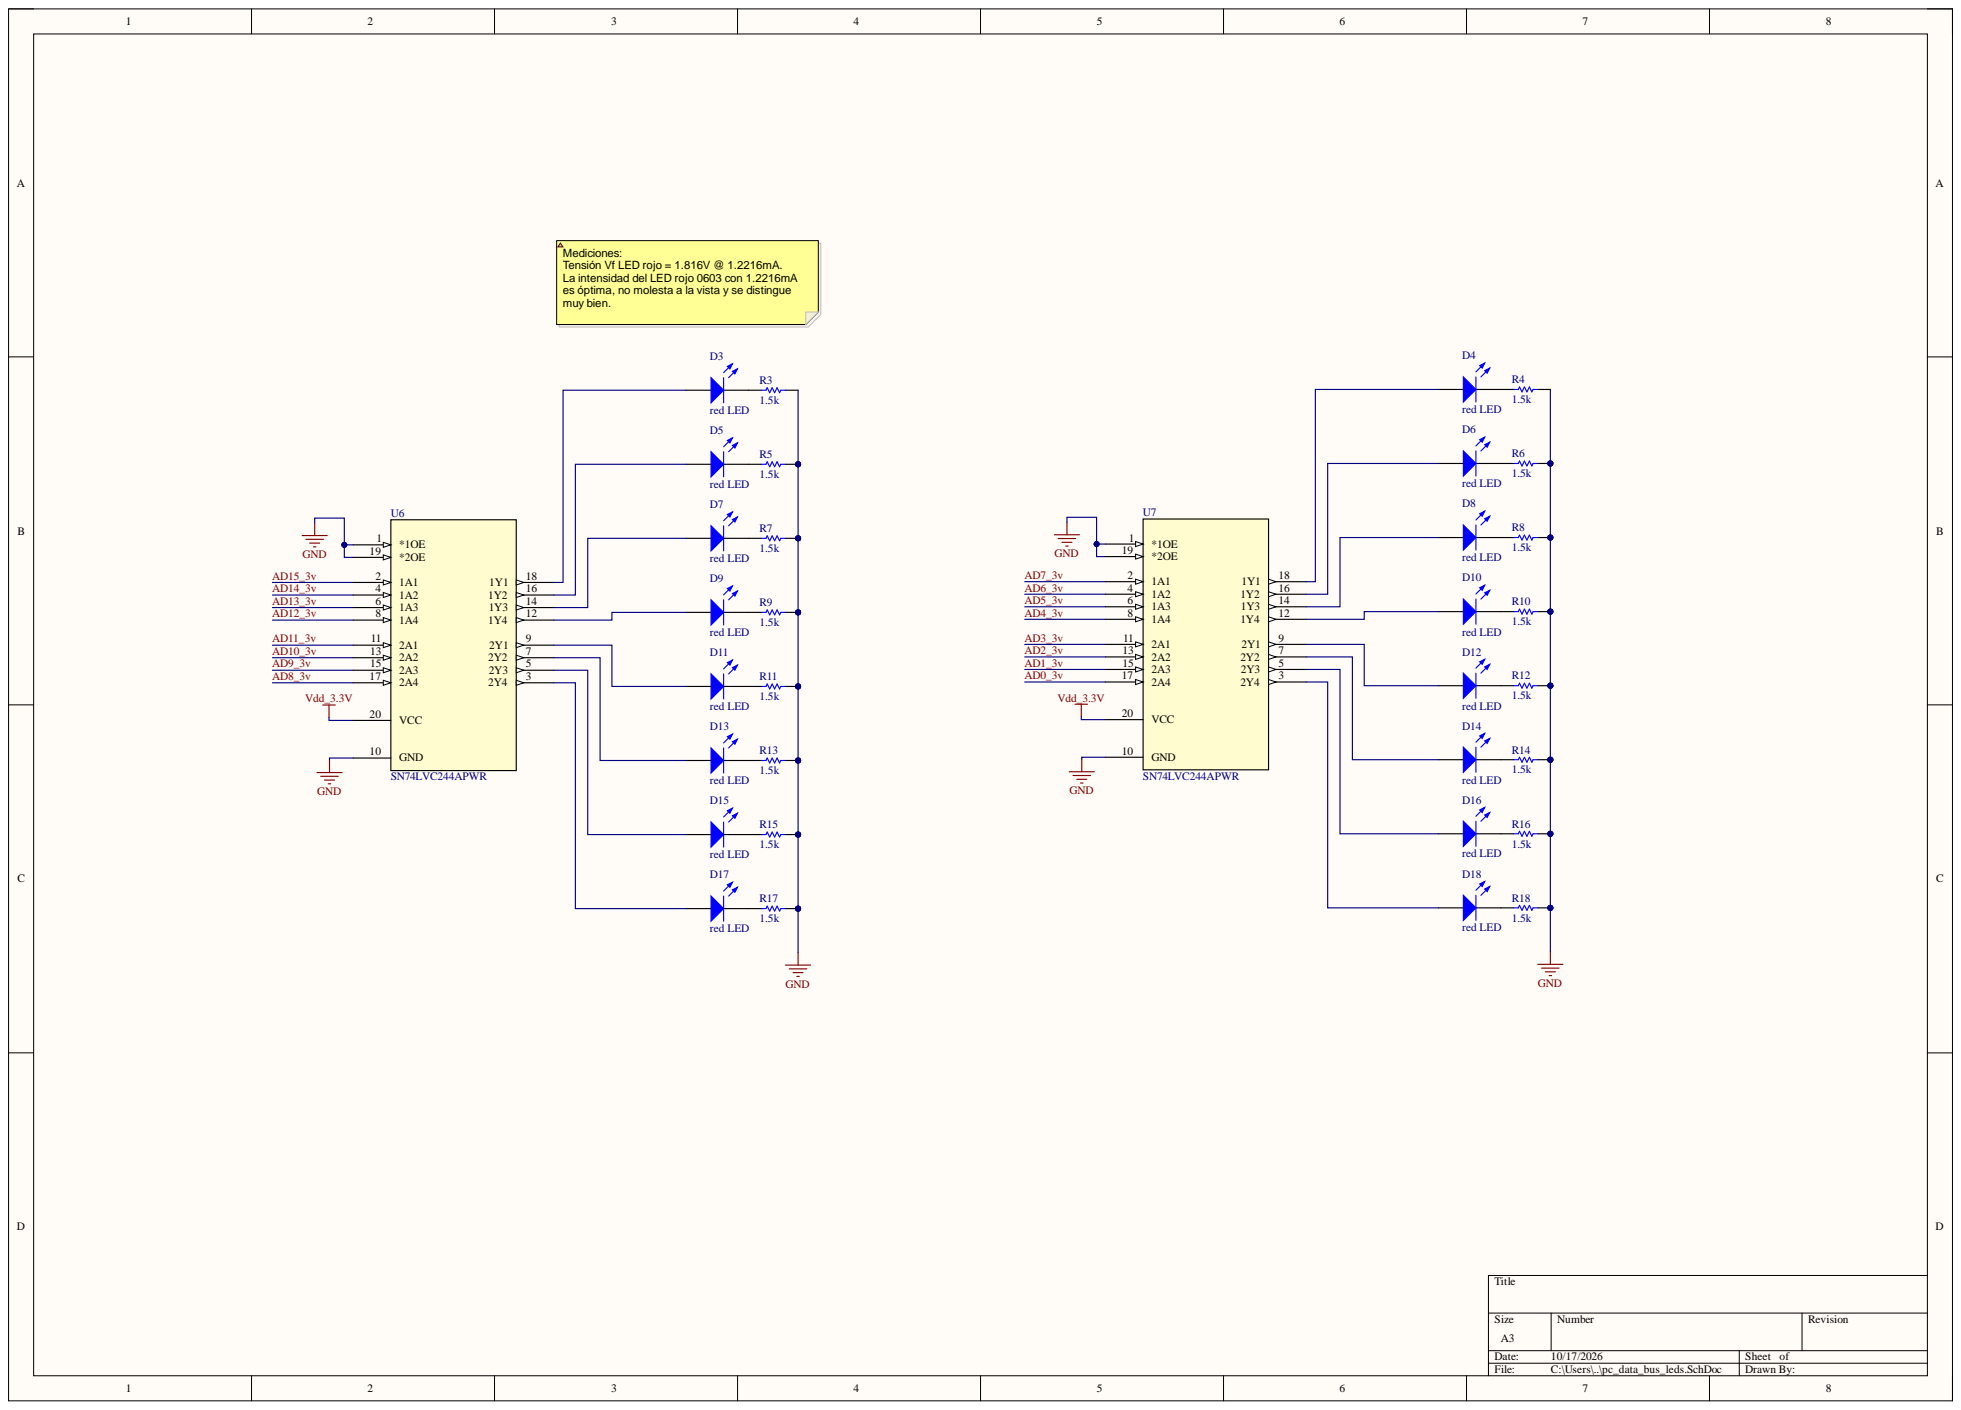
[picture p36: page 9]

rojo
rojo 0603 con 1.2216m
la vista y se dist

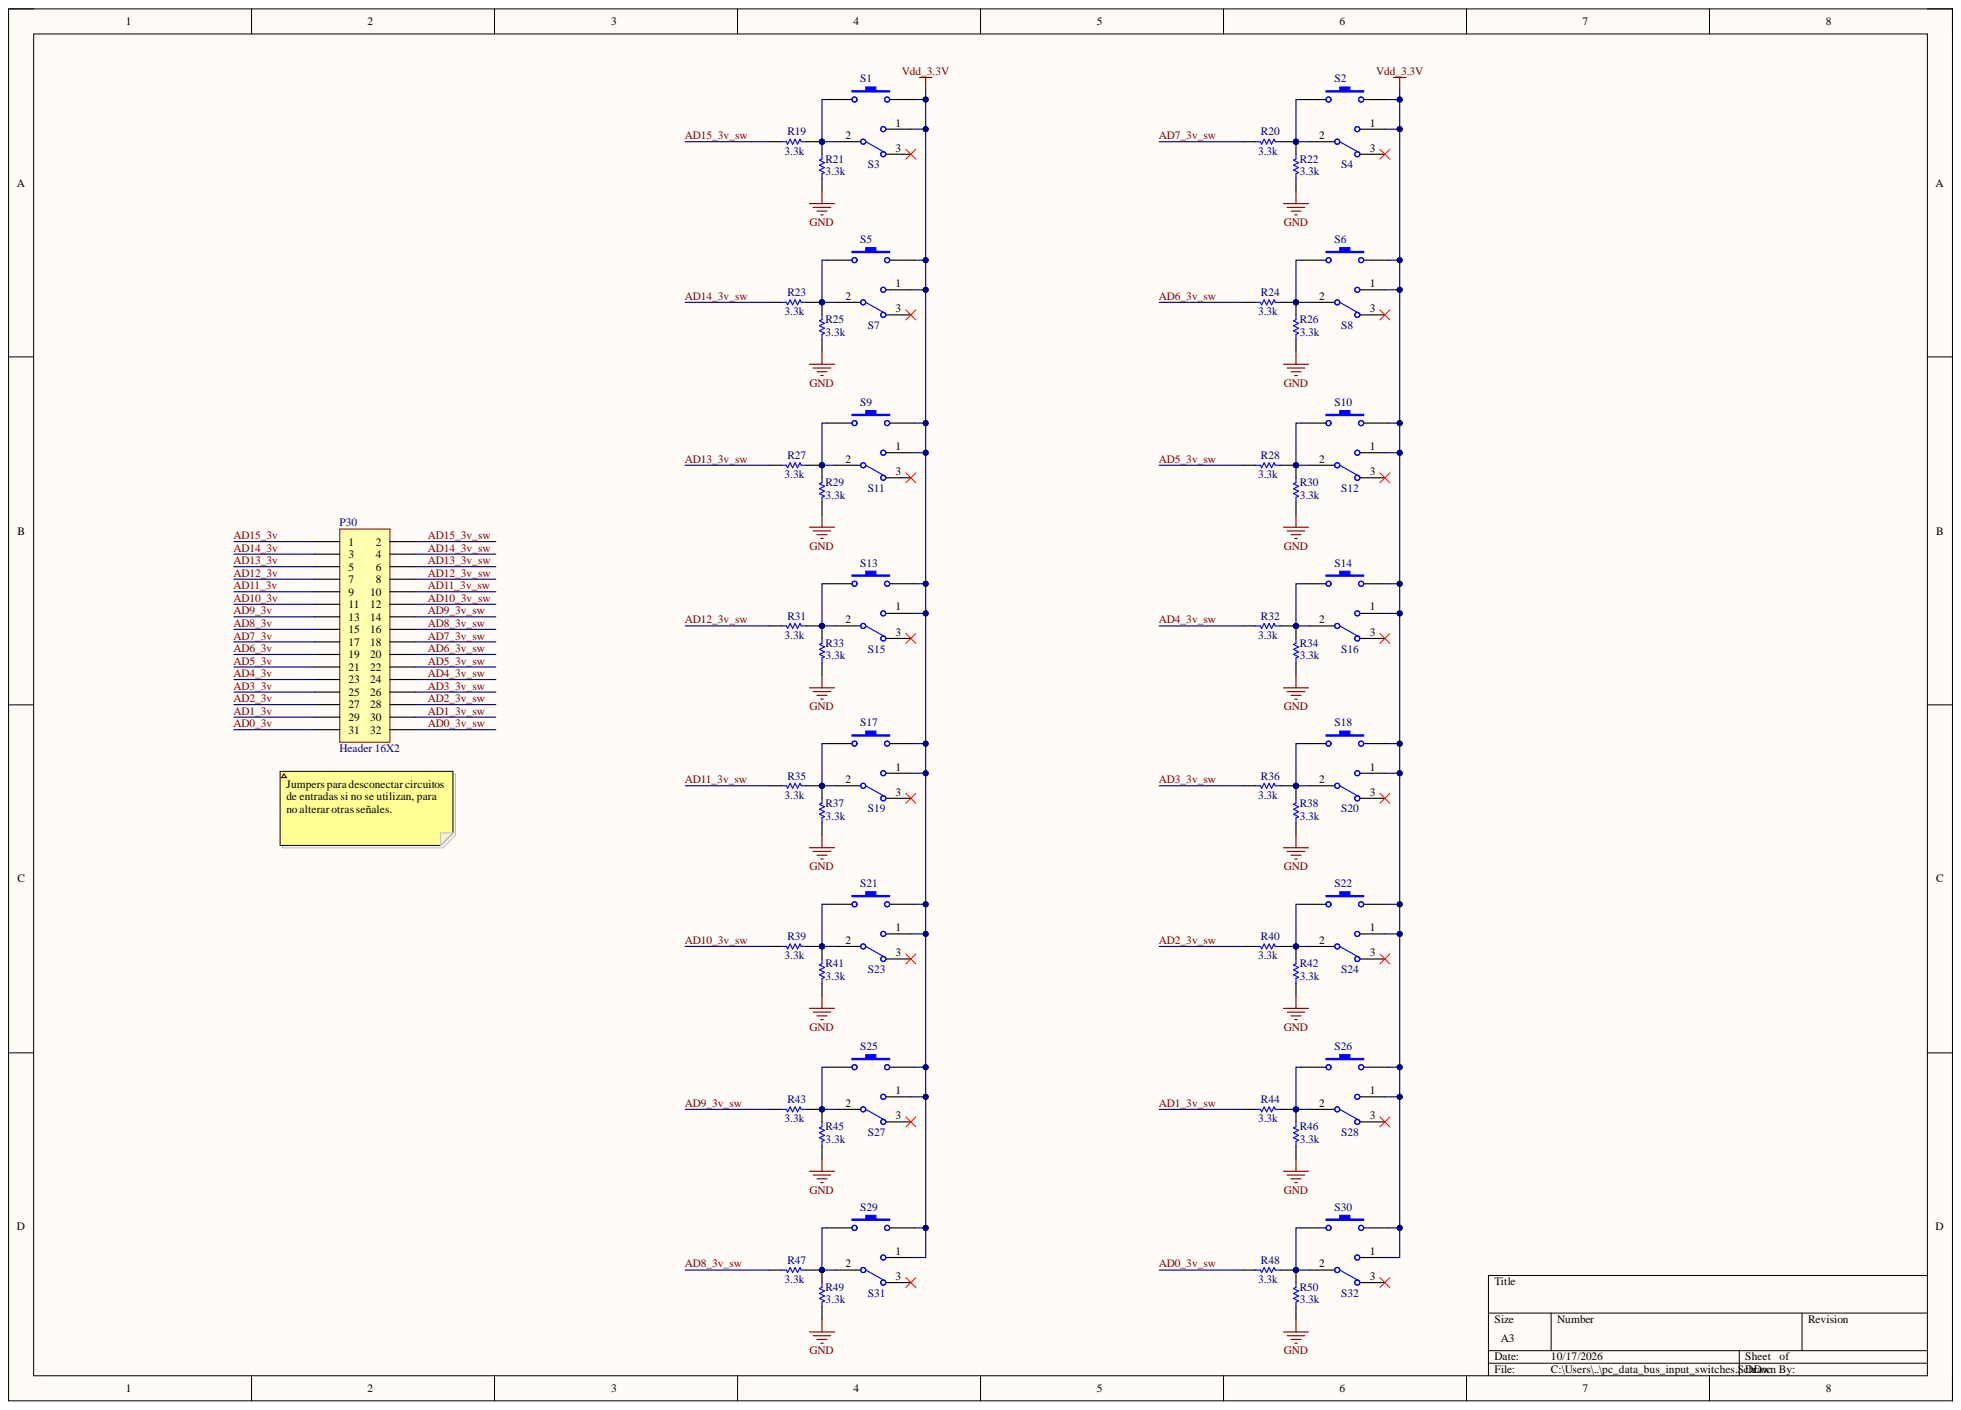
[picture p37: page 10]

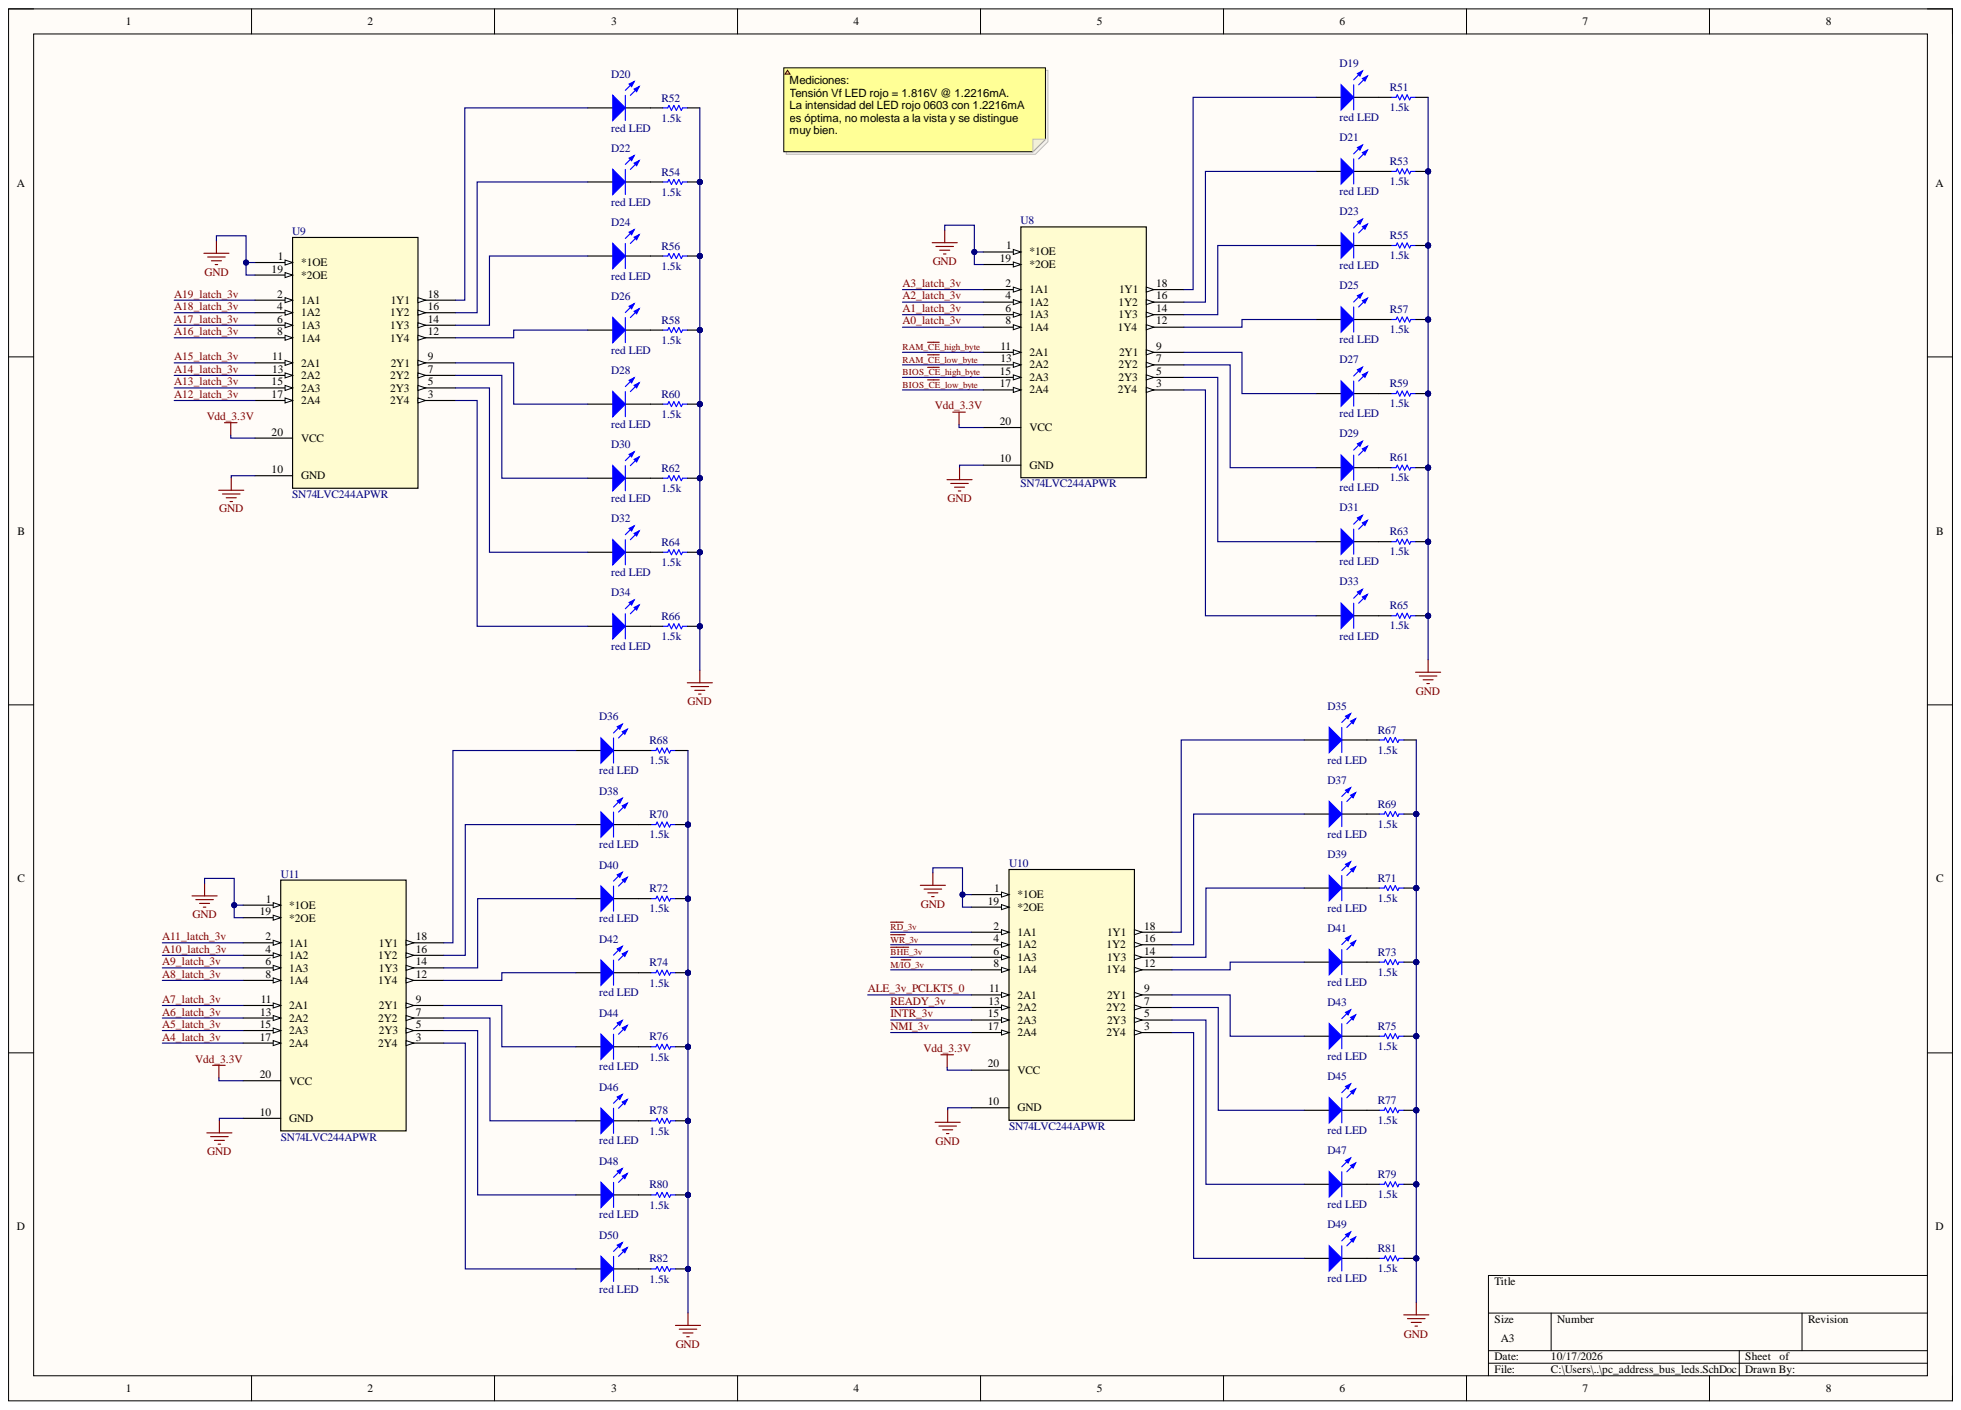
[picture p38: page 11]

rojo
rojo 0603 con 1.2216m
la vista y se dist

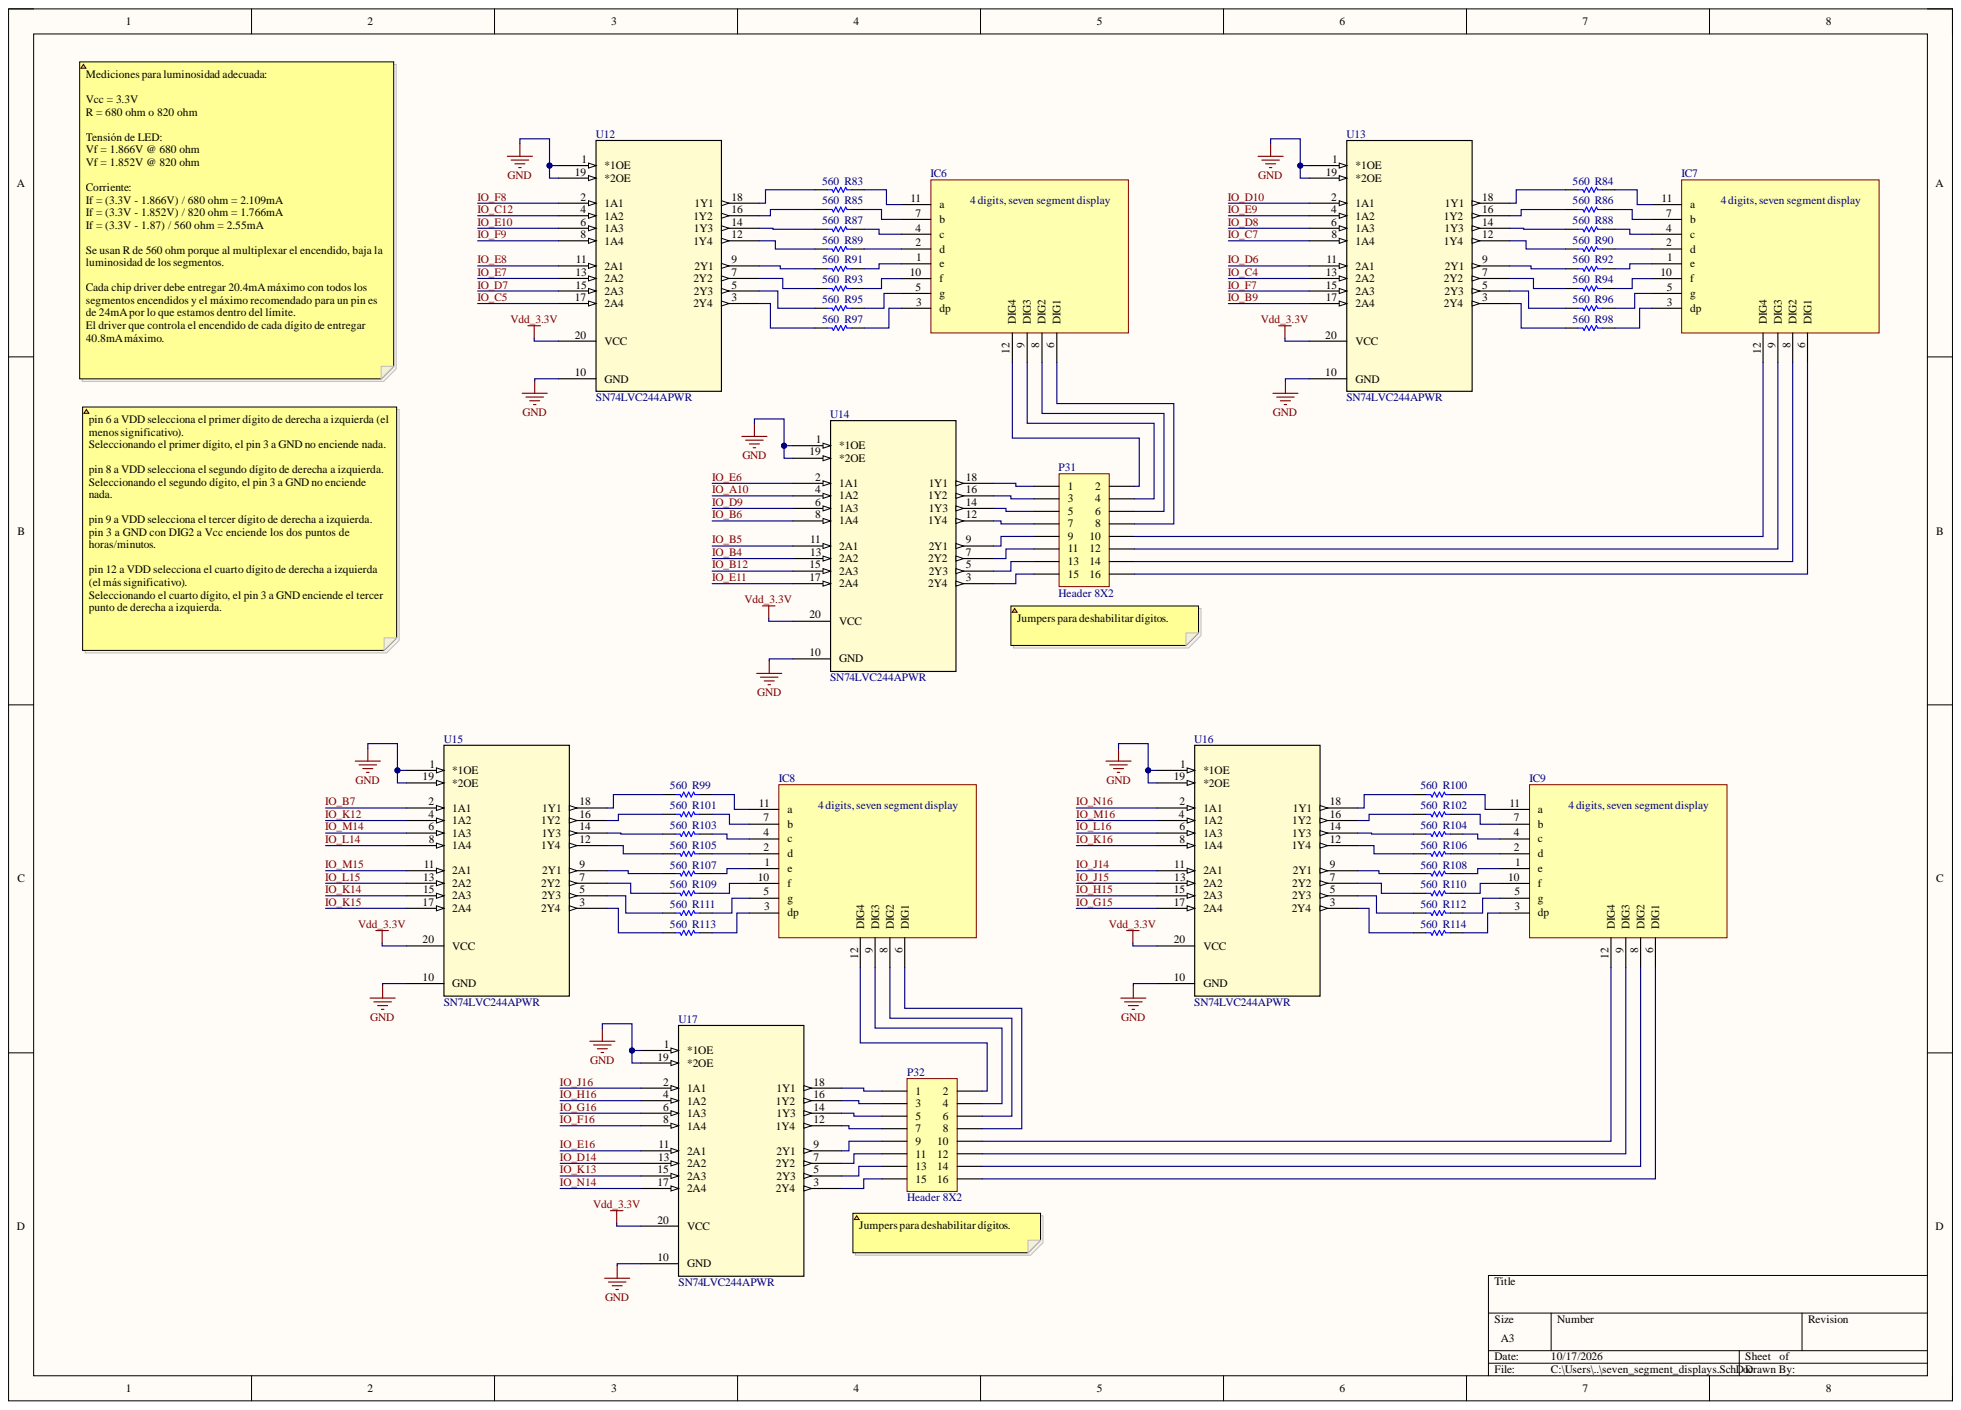
[picture p39: page 12]

Mediciones para luminosidad adecuada:

4 digits, seven segment display

Se usan R de 560 ohm porque al multiplexar el encendido, baja la
luminosidad de lossegmentos.

Cada chip driver debe entregar 20.4mAmáximo con todos los
segmentos encendidos y el máximo recomendado para un pin es
de 24mApor lo que estamos dentro del límite.
El driver que controla el encendido de cada dígito de entregar
40.8mAmáximo.

pin 6 a VDD selecciona el primer dígito de derecha a izquierda (el
menossignificativo).
Seleccionando el primer dígito, el pin 3 a GND no enciende nada.

pin 8 a VDD selecciona el segundo dígito de derecha a izquierda.
Seleccionando el segundo dígito, el pin 3 a GND no enciende
nada.

pin 9 a VDD selecciona el tercer dígito de derecha a izquierda.
pin 3 a GND con DIG2 a Vcc enciende los dos puntos de
horas/minutos.

pin 12 a VDD selecciona el cuarto dígito de derecha a izquierda
(el mássignificativo).
Seleccionando el cuarto dígito, el pin 3 a GND enciende el tercer

Jumpers para deshabilitar dígitos.

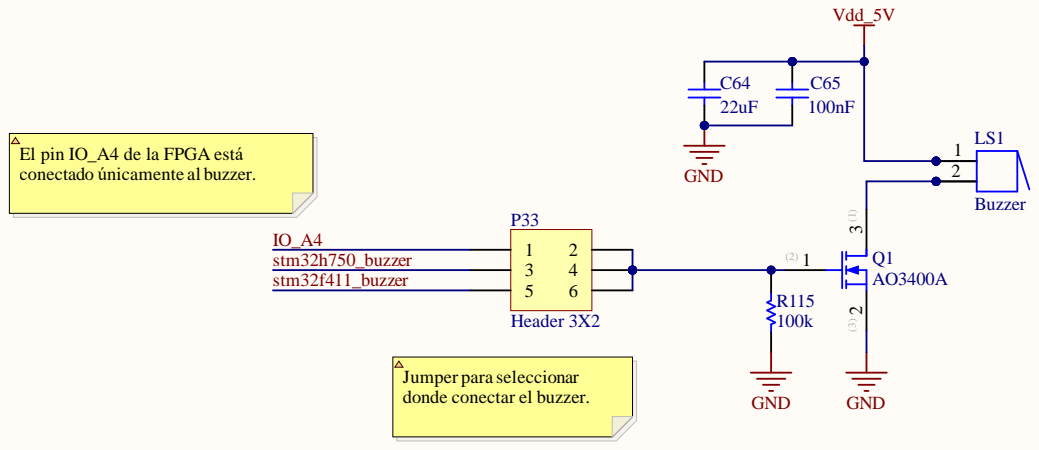
[picture p40: page 13]

Jumper para
donde conectar el buzzer

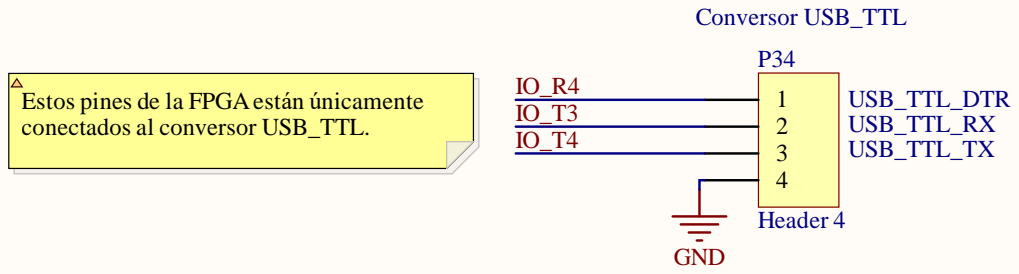
[picture p41: page 14]

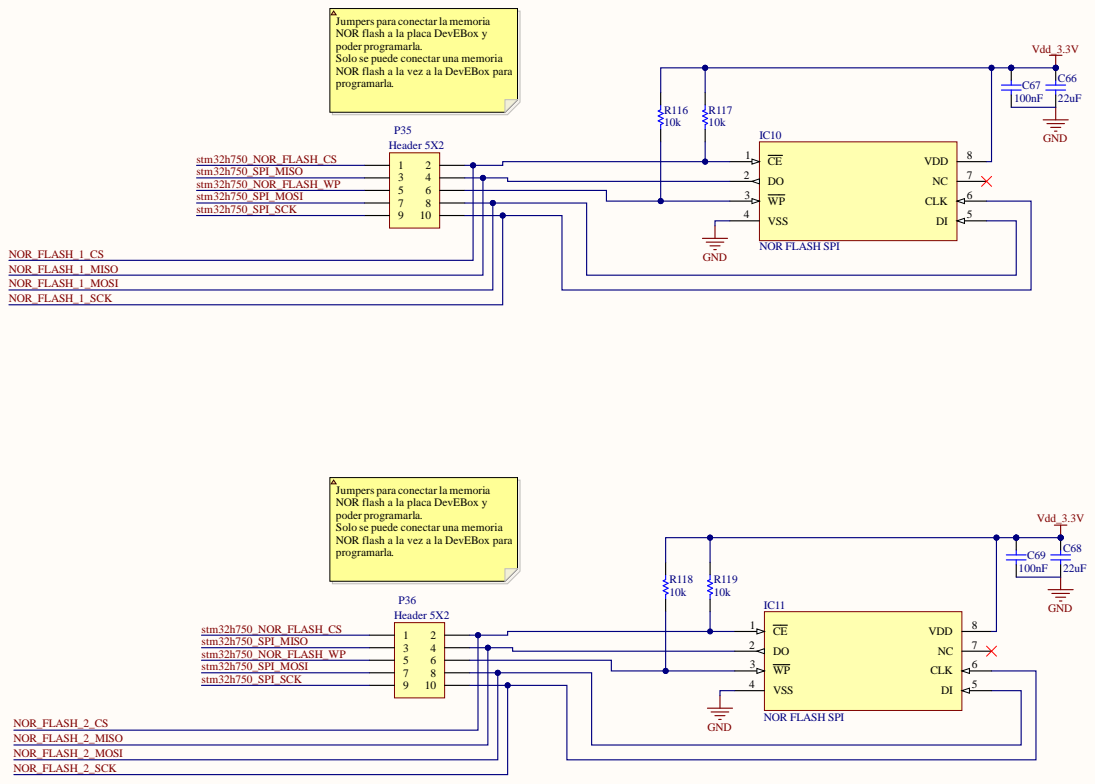
[picture p42: page 15]

Jumpers para conectarla memoria
NOR flash a la placa DevEBox y
poder programarla.
Solo se puede conectar una memoria
NOR flash a la vez a la DevEBox para
programarla.

stm32h750_SPI_MISO stm32h750_NOR_FLASH_WP stm32h750_SPI_MOSI | 3 4 5 6 7 8 | DO 2 WP 3

stm32h750_SPI_SCK | 9 10

NOR_FLASH_1_CS

NOR_FLASH_2_CS

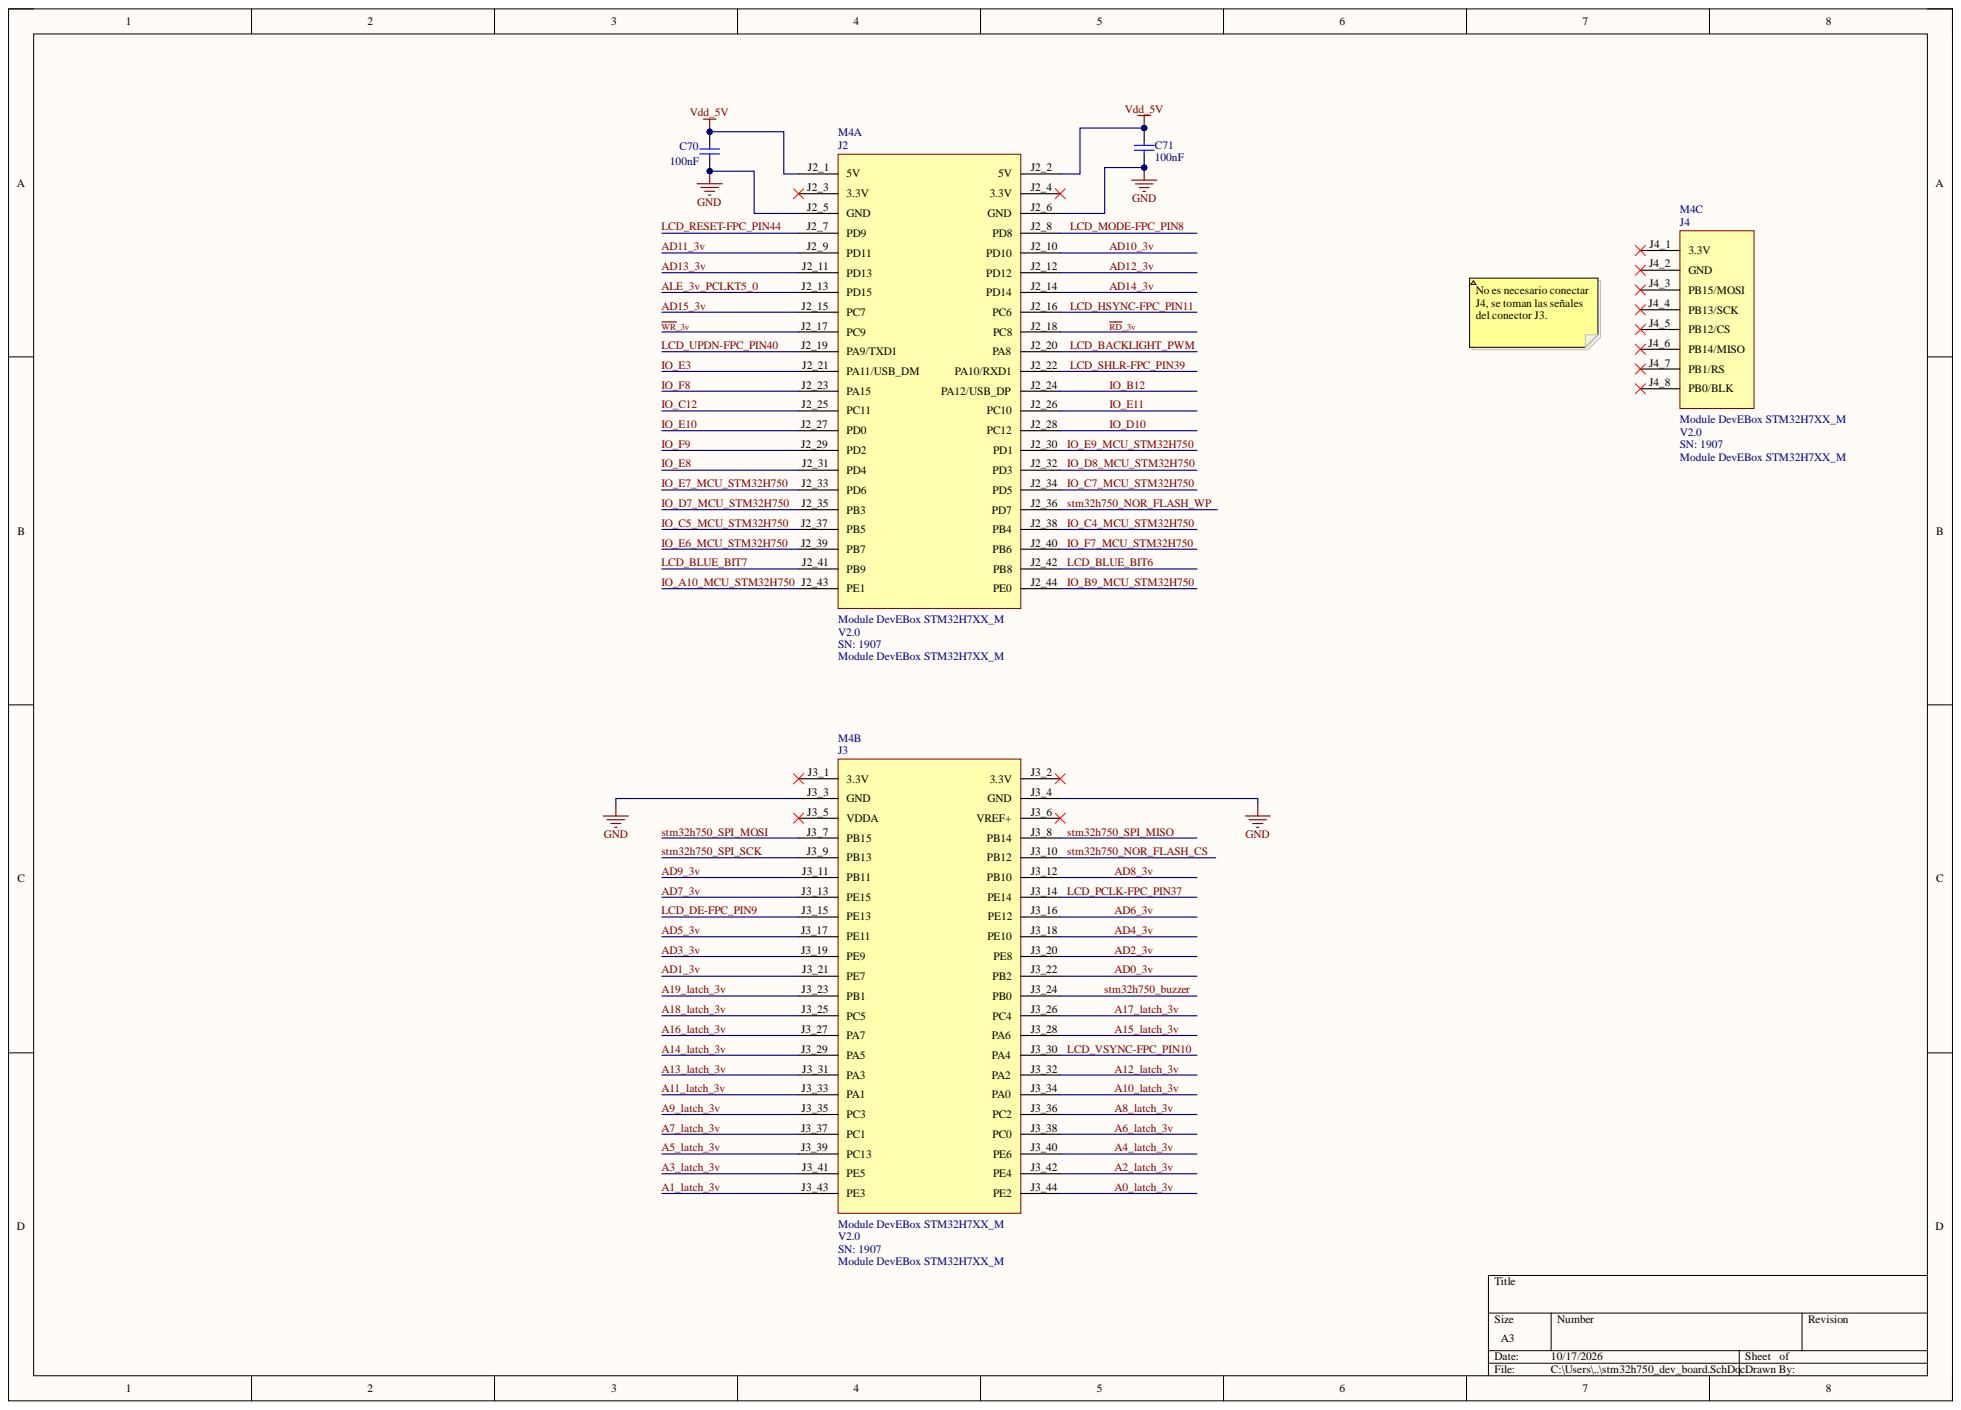
[picture p43: page 16]

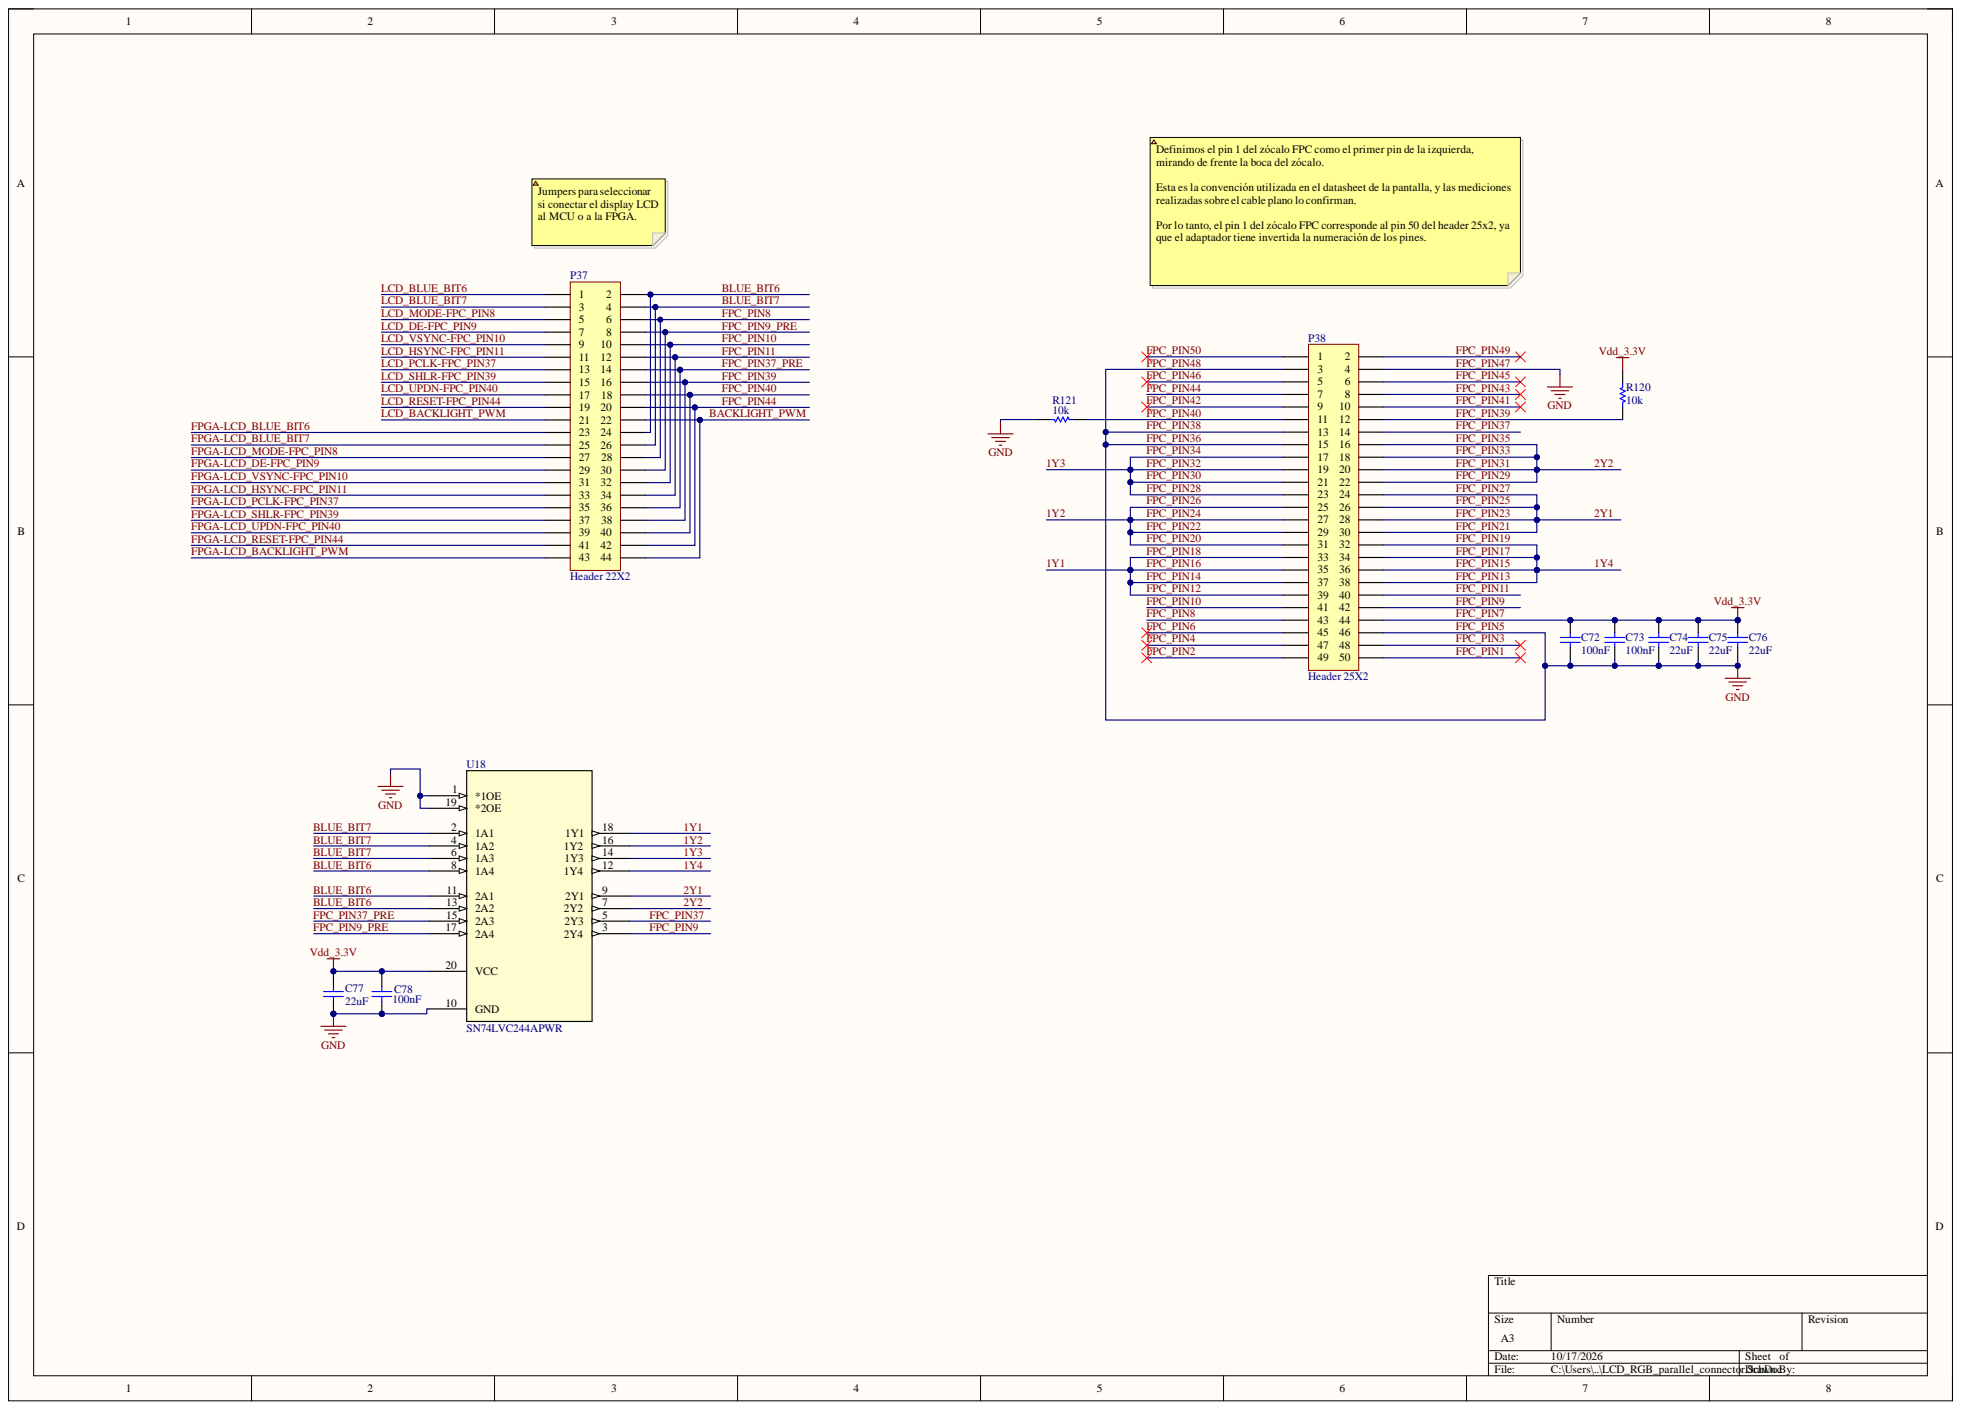
[picture p44: page 17]

mos el pin 1 del

ócalo FPC como el pr

la convenci
sobre el cable plano

izada en el datasheet de

tanto, el pin 1 del

responde al pin 50 del header 25x2, ya

FPC_PI N46 FPC_PI N44 FPC_PI N42 FPC_PI N40 FPC_PI N38

FPC_PI N36
FPC_PI N34 | FPC_PI N33
FPC_PI N32 | | FPC_PI N31
FPC_PI N30 | | FPC_PI N29
FPC_PI N28

FPC_PI N22 | FPC_PI N23

FPC_PI N20

FPC_PI N21

FPC_PI N16 FPC_PI N14 | FPC_PI N15

FPC_PI N13

FPC_PI N12

FPC_PI N 5

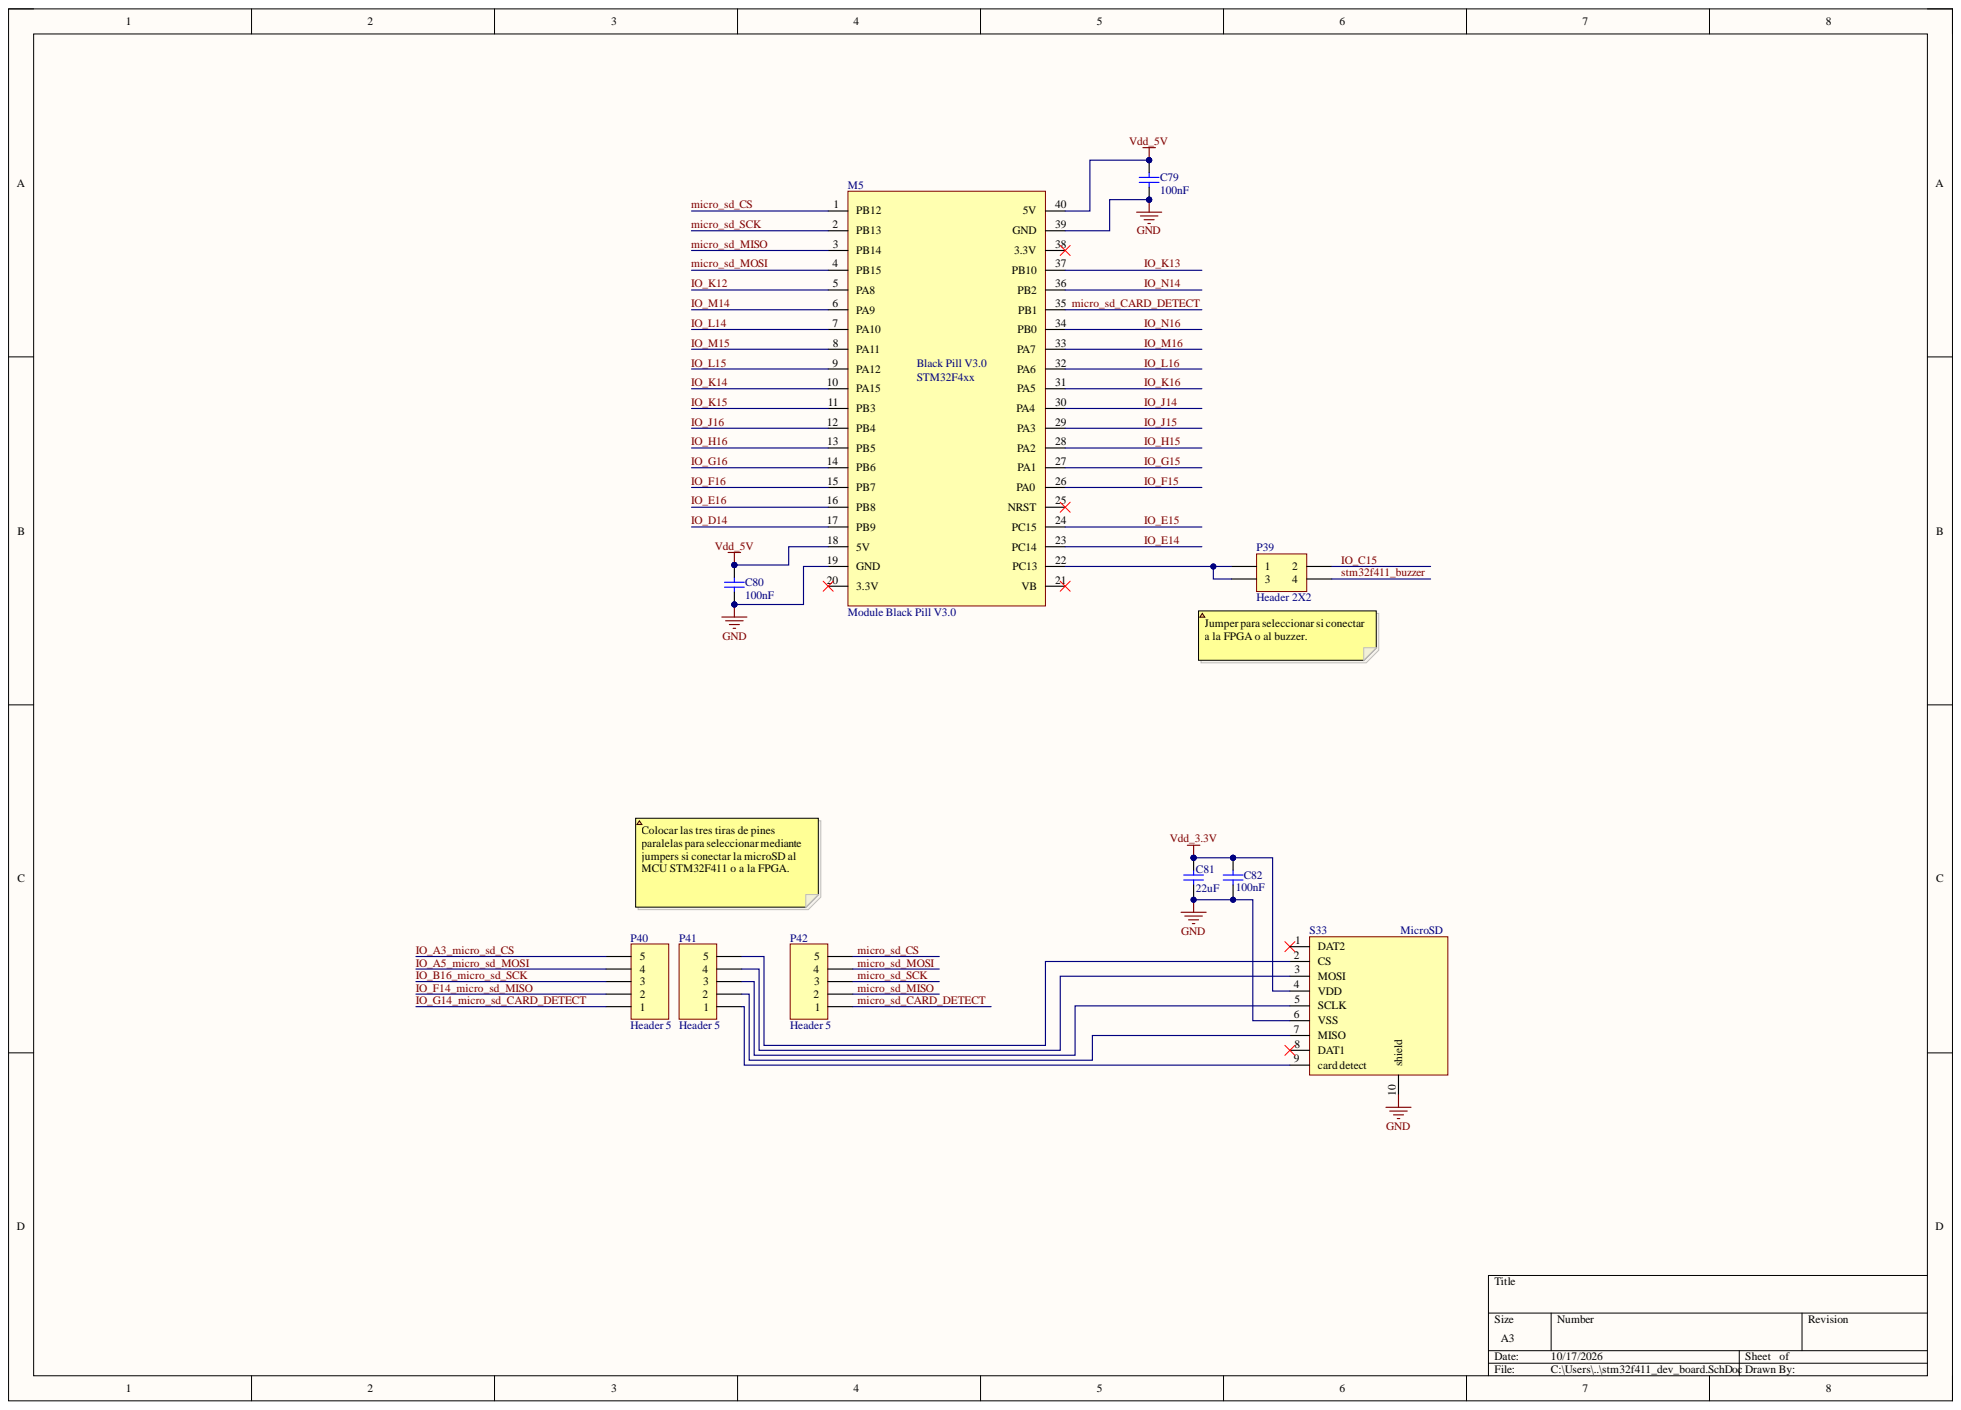
[picture p45: page 18]

Jumper para seleccionarsi conectar
a la FPGA o al buzzer.

Colocar las tres tiras de pines
paralelas para seleccionarmediante
jumpers si conectar la microSD al
MCU STM32F411 o a la FPGA.

MOSI 3
VDD 4
SCLK 5

1 | | VSS 6
