JuanHauara/FPGA_development_board/(list of files, drawings)

Other design files:
buzzer.SchDoc
FPGA_breadboard_connections.SchDoc
FPGA_J3_J4.SchDoc
FPGA_J6_J8.SchDoc
IBM_PC_CPU.SchDoc
IBM_PC_RAM.SchDoc
IBM_PC_ROM_BIOS.SchDoc
Lattice_FPGA_development_board.PrjPcb
LCD_RGB_parallel_connector.SchDoc
micro_sd.SchDoc
NOR_flash.SchDoc
pc_address_bus_leds.SchDoc
pc_data_bus_input_switches.SchDoc
pc_data_bus_leds.SchDoc
PCB.PcbDoc
power_supply.SchDoc
seven_segment_displays.SchDoc
stm32f411.SchDoc
stm32h750.SchDoc
USB_TTL_converter.SchDoc
