JuanHauara/FPGA_development_board/(commit log)

2026-10-17 Enumerar todos los componentes de los esquemáticos.
    [FPGA_J3_J4.SchDoc, FPGA_J6_J8.SchDoc, FPGA_breadboard_connections.SchDoc, FPGA_pin_access.SchDoc, IBM_PC_CPU.SchDoc, IBM_PC_RAM.SchDoc, IBM_PC_ROM_BIOS.SchDoc, LCD_RGB_parallel_connector.SchDoc]
2026-10-22 Modificar placa base para usar placa adaptadora de pantalla LCD.
    [IBM_PC_CPU.SchDoc, LCD_RGB_parallel_connector.SchDoc, Lattice_FPGA_development_board.PrjPcb, art_param.txt, buzzer.SchDoc, nc_param.txt, power_supply.SchDoc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]
2026-10-31 Fix slide switch footprint.
    [pc_data_bus_input_switches.SchDoc]
2026-11-04 Fix breadboards connection pins.
    [FPGA_J3_J4.SchDoc, FPGA_J6_J8.SchDoc, FPGA_breadboard_connections.SchDoc, FPGA_dev_board.PcbDoc, FPGA_interface_pins.SchDoc, IBM_PC_CPU.SchDoc, IBM_PC_RAM.SchDoc, IBM_PC_ROM_BIOS.SchDoc]
2026-11-09 Fix pin names.
    [FPGA_J3_J4.SchDoc, FPGA_breadboard_connections.SchDoc, FPGA_interface_pins.SchDoc, Lattice_FPGA_development_board.PrjPcb, PCB.PcbDoc, buzzer.SchDoc, micro_sd.SchDoc, power_supply.SchDoc]
2026-11-09 Position breadboard connectors.
    [FPGA_J6_J8.SchDoc, FPGA_breadboard_connections.SchDoc, FPGA_interface_pins.SchDoc, Lattice_FPGA_development_board.PrjPcb, PCB.PcbDoc]
2026-11-10 PCB: Place oscillators.
    [FPGA_J6_J8.SchDoc, NOR_flash.SchDoc, PCB.PcbDoc]
2026-11-10 Place P8 and P9.
    [FPGA_J6_J8.SchDoc, FPGA_breadboard_connections.SchDoc, PCB.PcbDoc]
2026-11-11 Place MCUs.
    [FPGA_J3_J4.SchDoc, FPGA_J6_J8.SchDoc, LCD_RGB_parallel_connector.SchDoc, Lattice_FPGA_development_board.PrjPcb, PCB.PcbDoc, stm32f411.SchDoc, stm32h750.SchDoc, stm32h750_dev_board.SchDoc]
2026-11-11 Route LCD connectors.
    [FPGA_J3_J4.SchDoc, LCD_RGB_parallel_connector.SchDoc, PCB.PcbDoc]
2026-11-13 Route P1 and P38.
    [FPGA_J3_J4.SchDoc, PCB.PcbDoc, stm32h750.SchDoc]
2026-11-13 Route MicroSD.
    [PCB.PcbDoc, micro_sd.SchDoc]
